jasperbom/nerdhome-breeze/daikin/docs/render_bottom.png

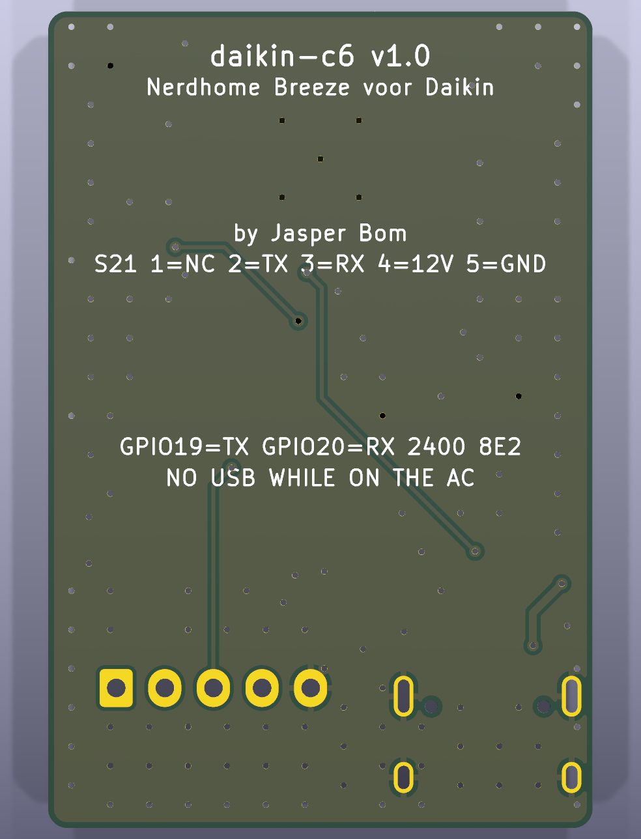
daikin/docs/render_bottom.png
