jasperbom/nerdhome-breeze/daikin/docs/render_top.png

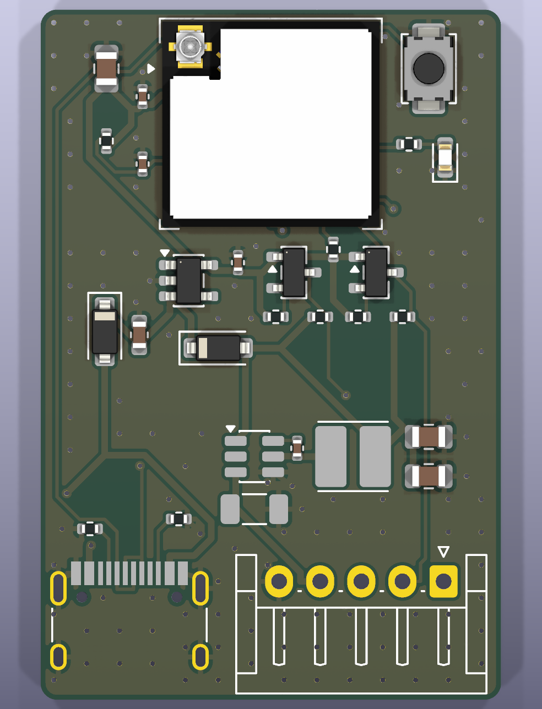
daikin/docs/render_top.png
