jasperbom/nerdhome-breeze/toshiba/docs/product_enclosure.png

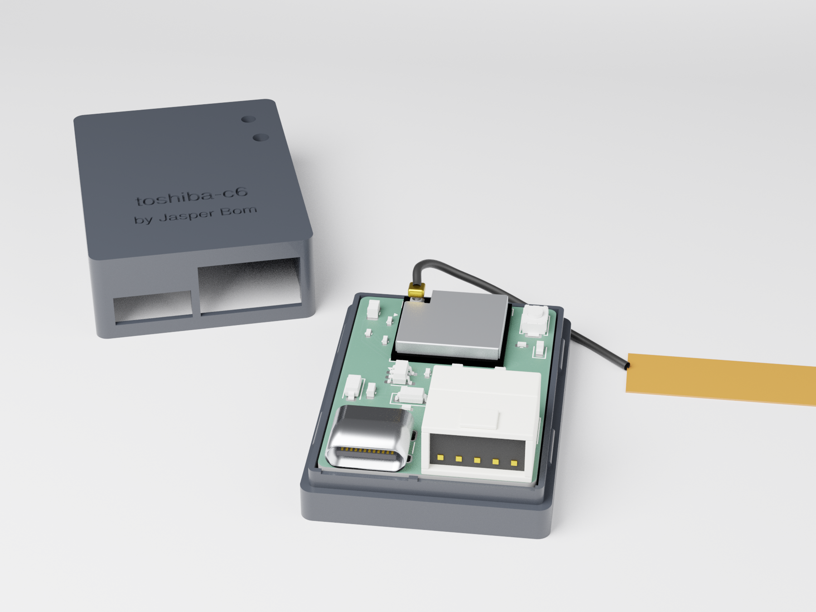
toshiba/docs/product_enclosure.png
