jasperbom/nerdhome-breeze/toshiba/docs/render_bottom.png

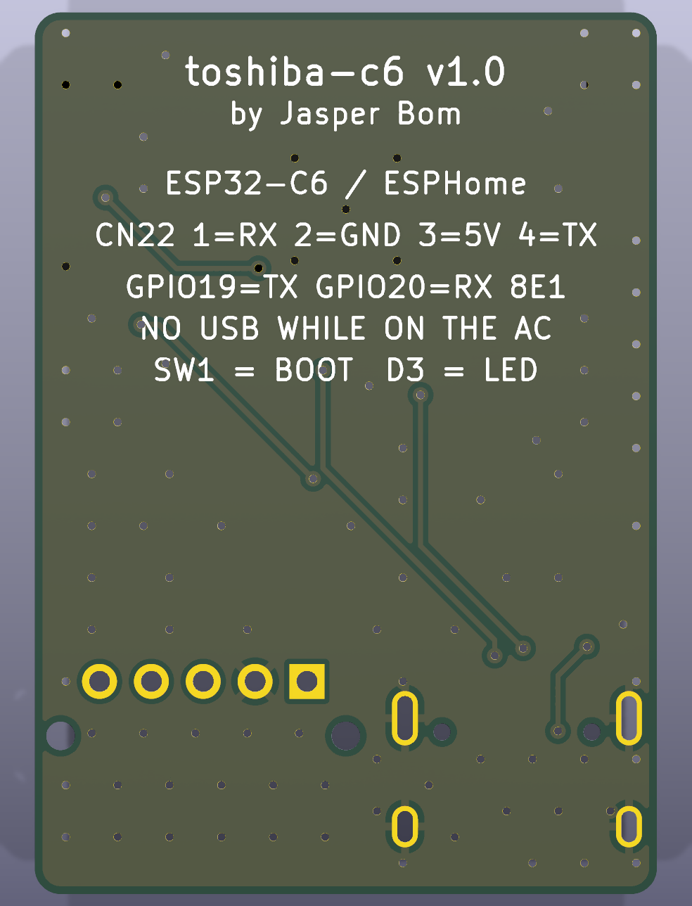
toshiba/docs/render_bottom.png
