jasperbom/nerdhome-breeze/toshiba/docs/render_top.png

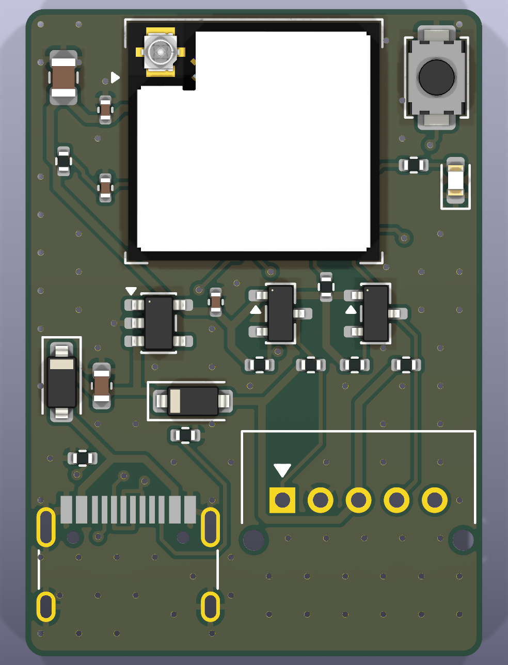
toshiba/docs/render_top.png
