jasperbom/nerdhome-breeze/daikin/production/daikin-c6_bom_jlcpcb.csv

Comment | Designator | Footprint | LCSC Part # | Quantity | MPN
10uF | C1 | C_0603_1608Metric | C19702 | 1 | CL10A106KP8NNNC
22uF | C2,C7,C8 | C_0805_2012Metric | C45783 | 3 | CL21A226MAQNNNE
100nF | C3,C9 | C_0402_1005Metric | C1525 | 2 | CL05B104KO5NNNC
1uF | C4,C5 | C_0402_1005Metric | C52923 | 2 | CL05A105KA5NQNC
10uF 50V | C6 | C_1206_3216Metric | C13585 | 1 | CL31A106KBHNNNE
B5819W | D1,D2 | D_SOD-123 | C8598 | 2 | B5819W SL
Red | D3 | LED_0603_1608Metric | C2286 | 1 | KT-0603R
Daikin S21 (JST EH) | J1 | JST_EH_S5B-EH_1x05_P2.50mm_Horizontal | C265103 | 1 | S5B-EH(LF)(SN)
USB-C | J2 | USB_C_Receptacle_HRO_TYPE-C-31-M-12 | C165948 | 1 | TYPE-C-31-M-12
4.7uH | L1 | L_Cenker_CKCS4030 | C354587 | 1 | CKCS4030-4.7uH/M
AO3400A | Q1,Q2 | SOT-23 | C20917 | 2 | AO3400A
10k | R1,R2,R3,R4,R5,R6 | R_0402_1005Metric | C25744 | 6 | 0402WGF1002TCE
1k | R7 | R_0402_1005Metric | C11702 | 1 | 0402WGF1001TCE
5.1k | R8,R9 | R_0402_1005Metric | C25905 | 2 | 0402WGF5101TCE
BOOT | SW1 | SW_SPST_TS-1088-xR020 | C455280 | 1 | TS-1088R-02026
ESP32-C6-MINI-1U-H4 | U1 | ESP32-C6-MINI-1U | C20627095 | 1 | ESP32-C6-MINI-1U-H4
AP2112K-3.3 | U2 | SOT-23-5 | C51118 | 1 | AP2112K-3.3TRG1
AP63205WU-7 | U3 | TSOT-23-6 | C2071056 | 1 | AP63205WU-7
