jasperbom/nerdhome-breeze/daikin/hardware/3dmodels/ESP32-C6-MINI-1U.step

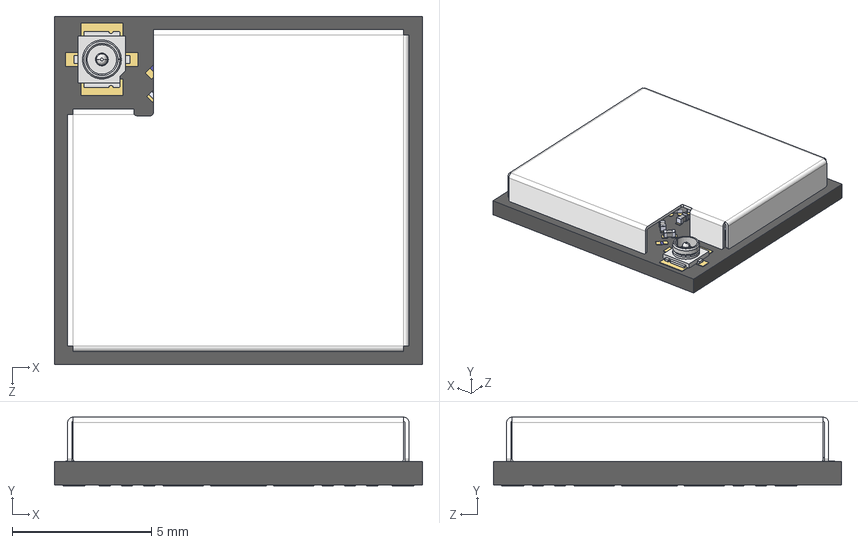
[picture p8: CAD file, 2026-10-19]
daikin/hardware/3dmodels/ESP32-C6-MINI-1U.step
13.2 x 2.47 x 12.5 mm
uid__2428
ipx3.xtd
R0201_20210301.xtd x 3
L0201_20210301.xtd x 2
C0201_20210301.xtd x 10
C0402_20210301.xtd
DFN1006.xtd
XTAL3225_20210301.xtd
ESP32-C6_QFN32_5X5_202306.xtd
placementOutline
Imported
C3-MINI-solder_pad
ShieldBox_ESP32-C3-MINI-1U_V1.0_20201210
