jasperbom/nerdhome-breeze/toshiba/enclosure/toshiba-c6_mount_lid.step

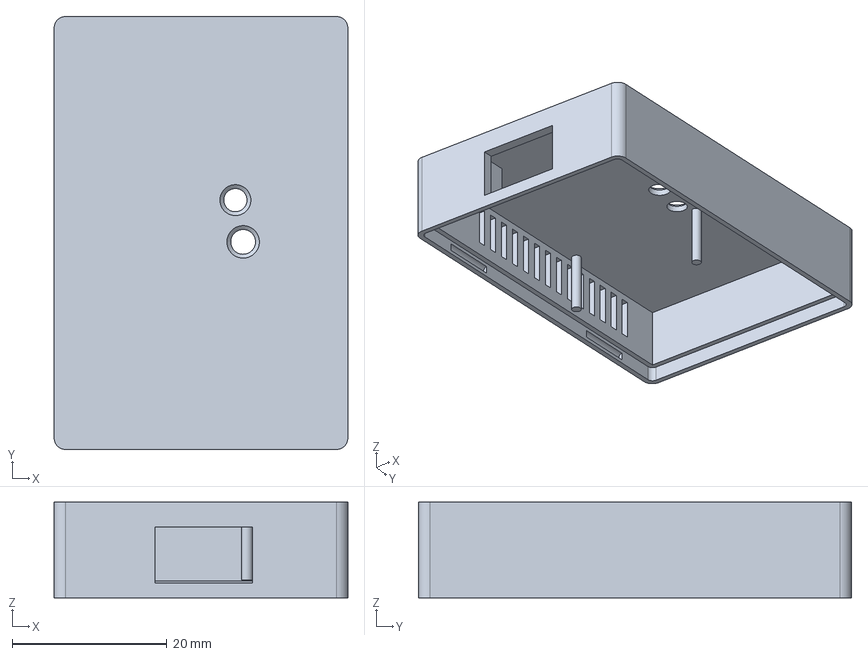
[picture p9: CAD file, 2026-10-19]
toshiba/enclosure/toshiba-c6_mount_lid.step
38.0 x 56.0 x 12.4 mm
