jasperbom/nerdhome-breeze/toshiba/enclosure/toshiba-c6_mount_base.step

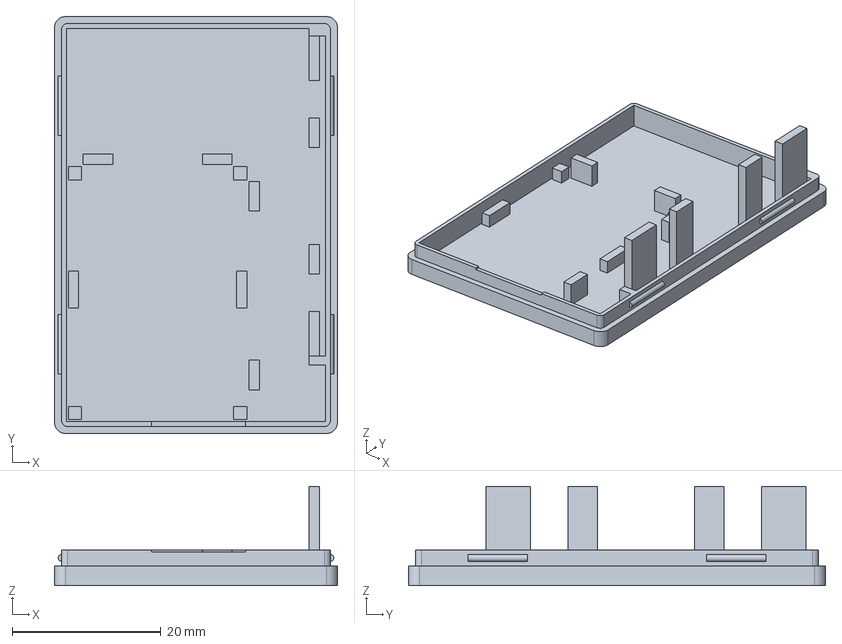
[picture p10: CAD file, 2026-10-19]
toshiba/enclosure/toshiba-c6_mount_base.step
38.0 x 56.0 x 13.3 mm
