jasperbom/nerdhome-breeze/toshiba/enclosure/toshiba-c6_lid.step

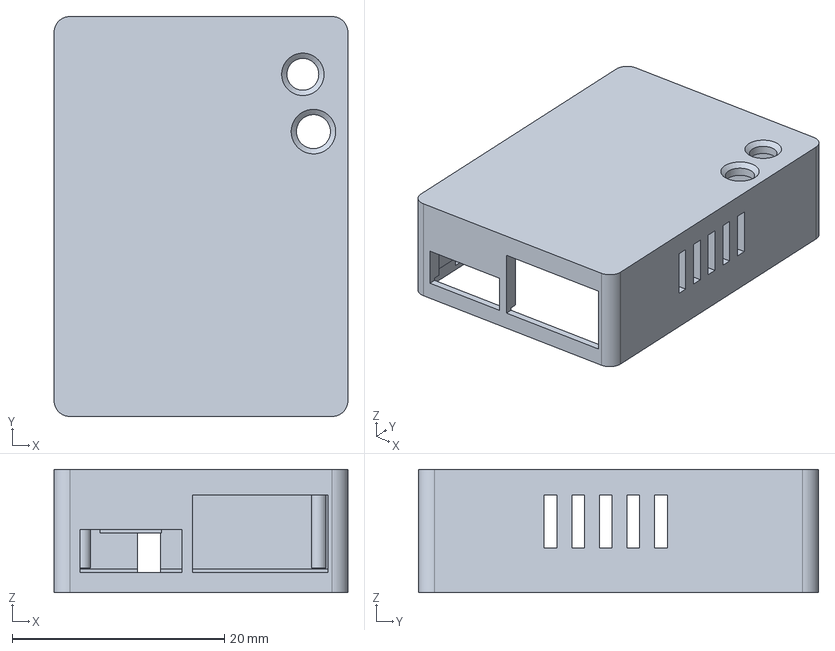
[picture p11: CAD file, 2026-10-19]
toshiba/enclosure/toshiba-c6_lid.step
27.7 x 37.7 x 11.6 mm
