jasperbom/nerdhome-breeze/toshiba/enclosure/toshiba-c6_base.step

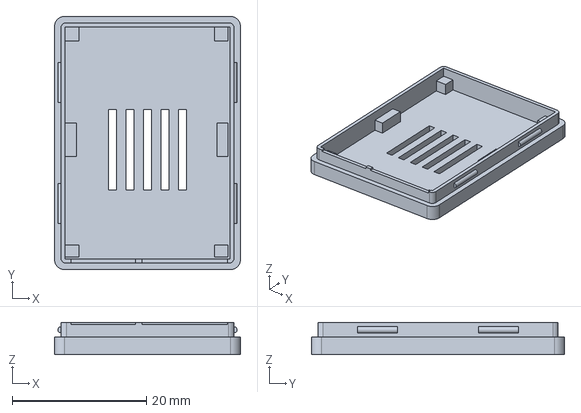
[picture p12: CAD file, 2026-10-19]
toshiba/enclosure/toshiba-c6_base.step
27.7 x 37.7 x 4.80 mm
