jasperbom/nerdhome-breeze/(list of files, cad)

Other CAD files:
toshiba/enclosure/toshiba-c6_base.stl
toshiba/enclosure/toshiba-c6_lid.stl
toshiba/enclosure/toshiba-c6_mount_base.stl
toshiba/enclosure/toshiba-c6_mount_lid.stl
