jasperbom/nerdhome-breeze/toshiba/docs/assembly_top.png

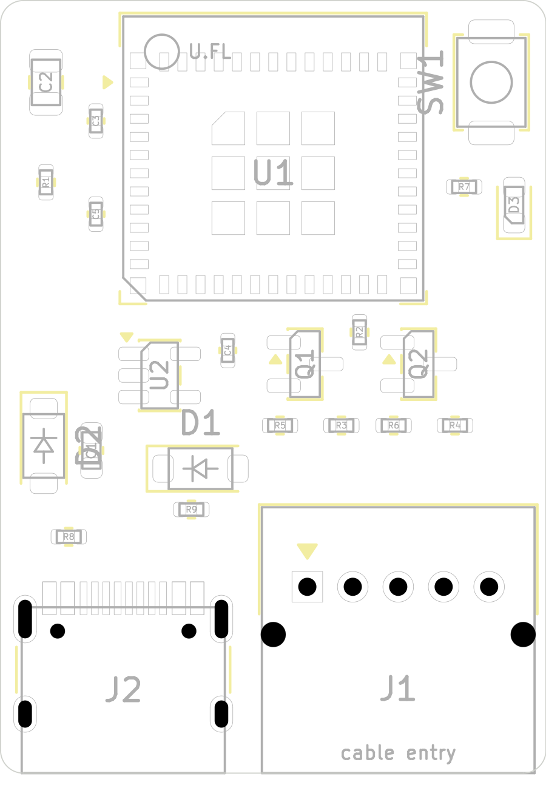
toshiba/docs/assembly_top.png
