jasperbom/nerdhome-breeze/daikin/docs/daikin-c6_assembly.pdf

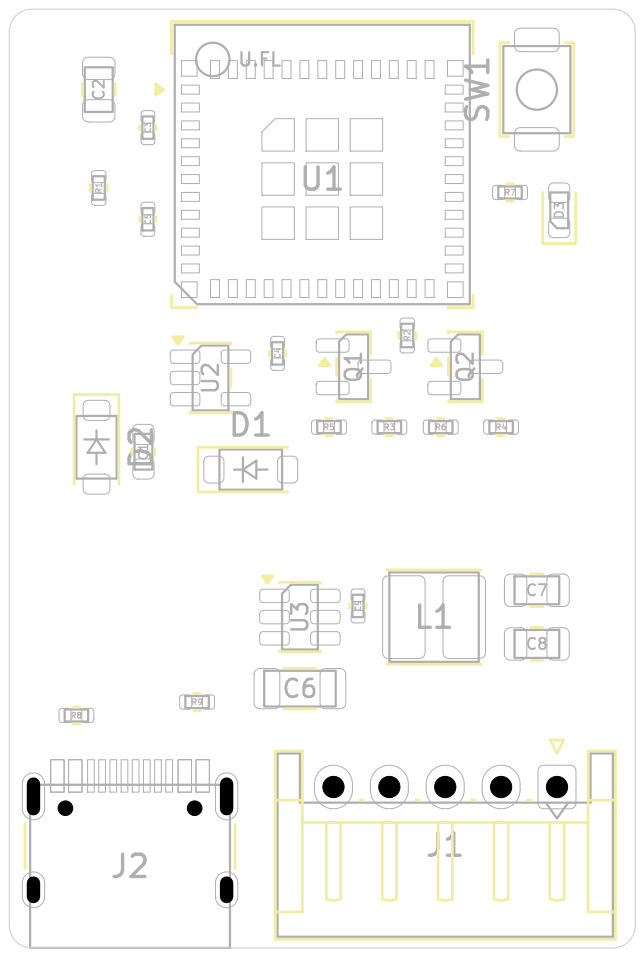
[picture p14: page 1]

Id: 1/1 Title: File: daikin-c6.kicad_pcb Sheet:
