jasperbom/nerdhome-breeze/daikin/docs/daikin-c6_schematic.pdf

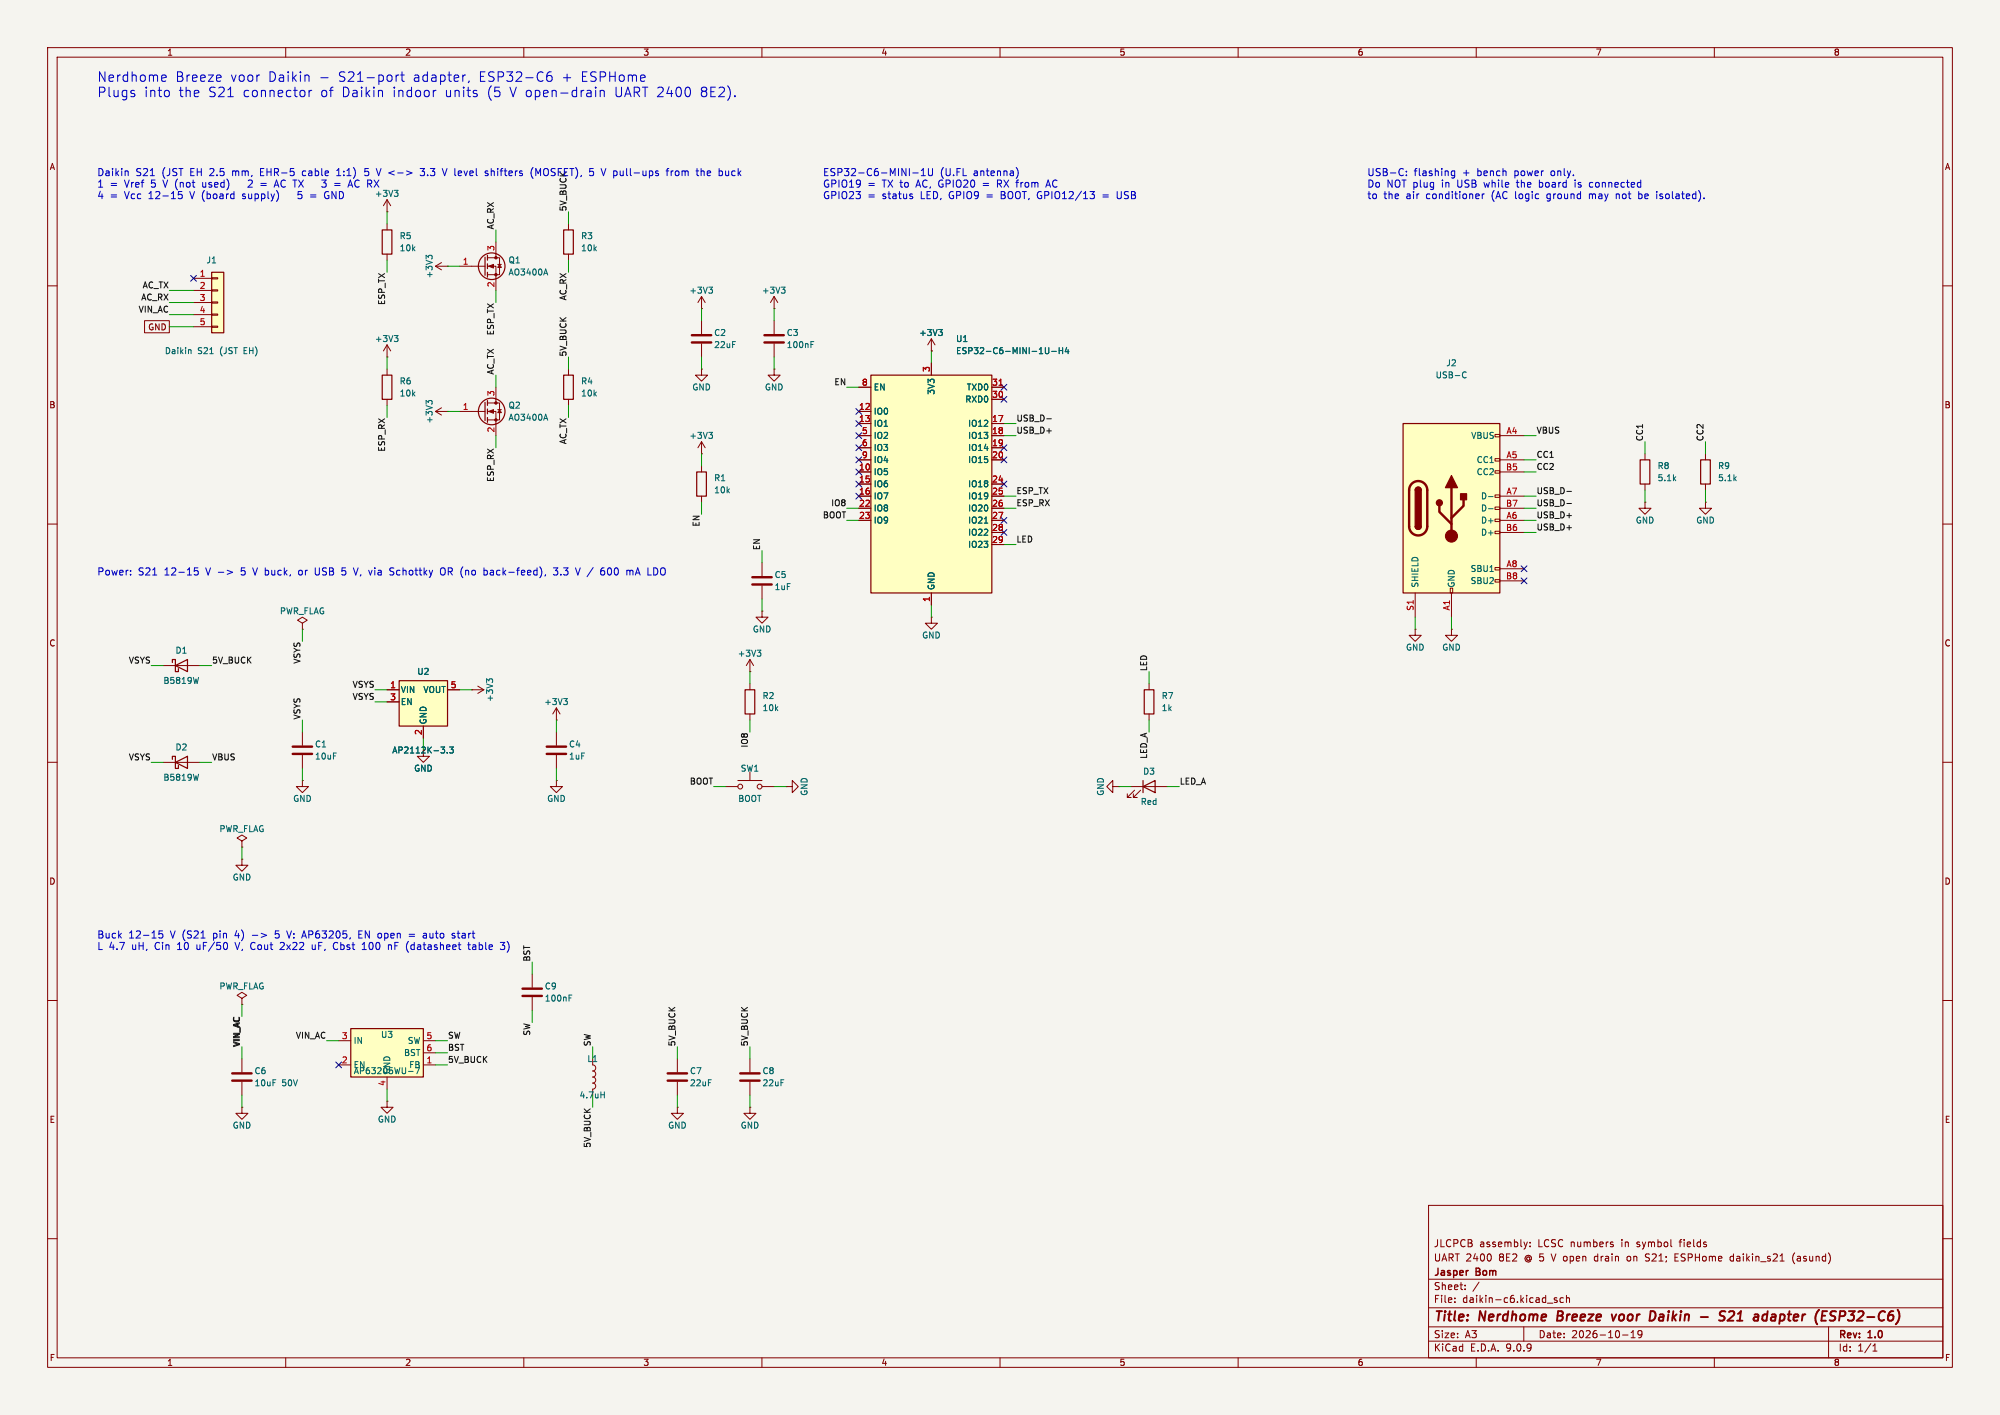
[picture p15: page 1]

4 SW 5 BST 6 FB 1 U3 AP63205WU-7 GND
