jasperbom/nerdhome-breeze/toshiba/docs/toshiba-c6_assembly.pdf

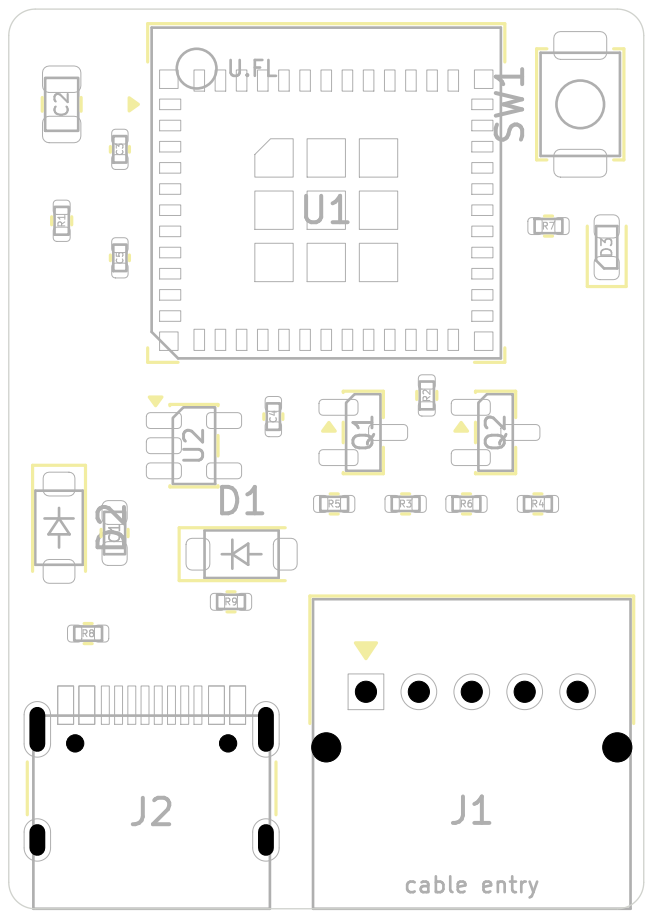
[picture p16: page 1]
