jasperbom/nerdhome-breeze/toshiba/docs/toshiba-c6_schematic.pdf

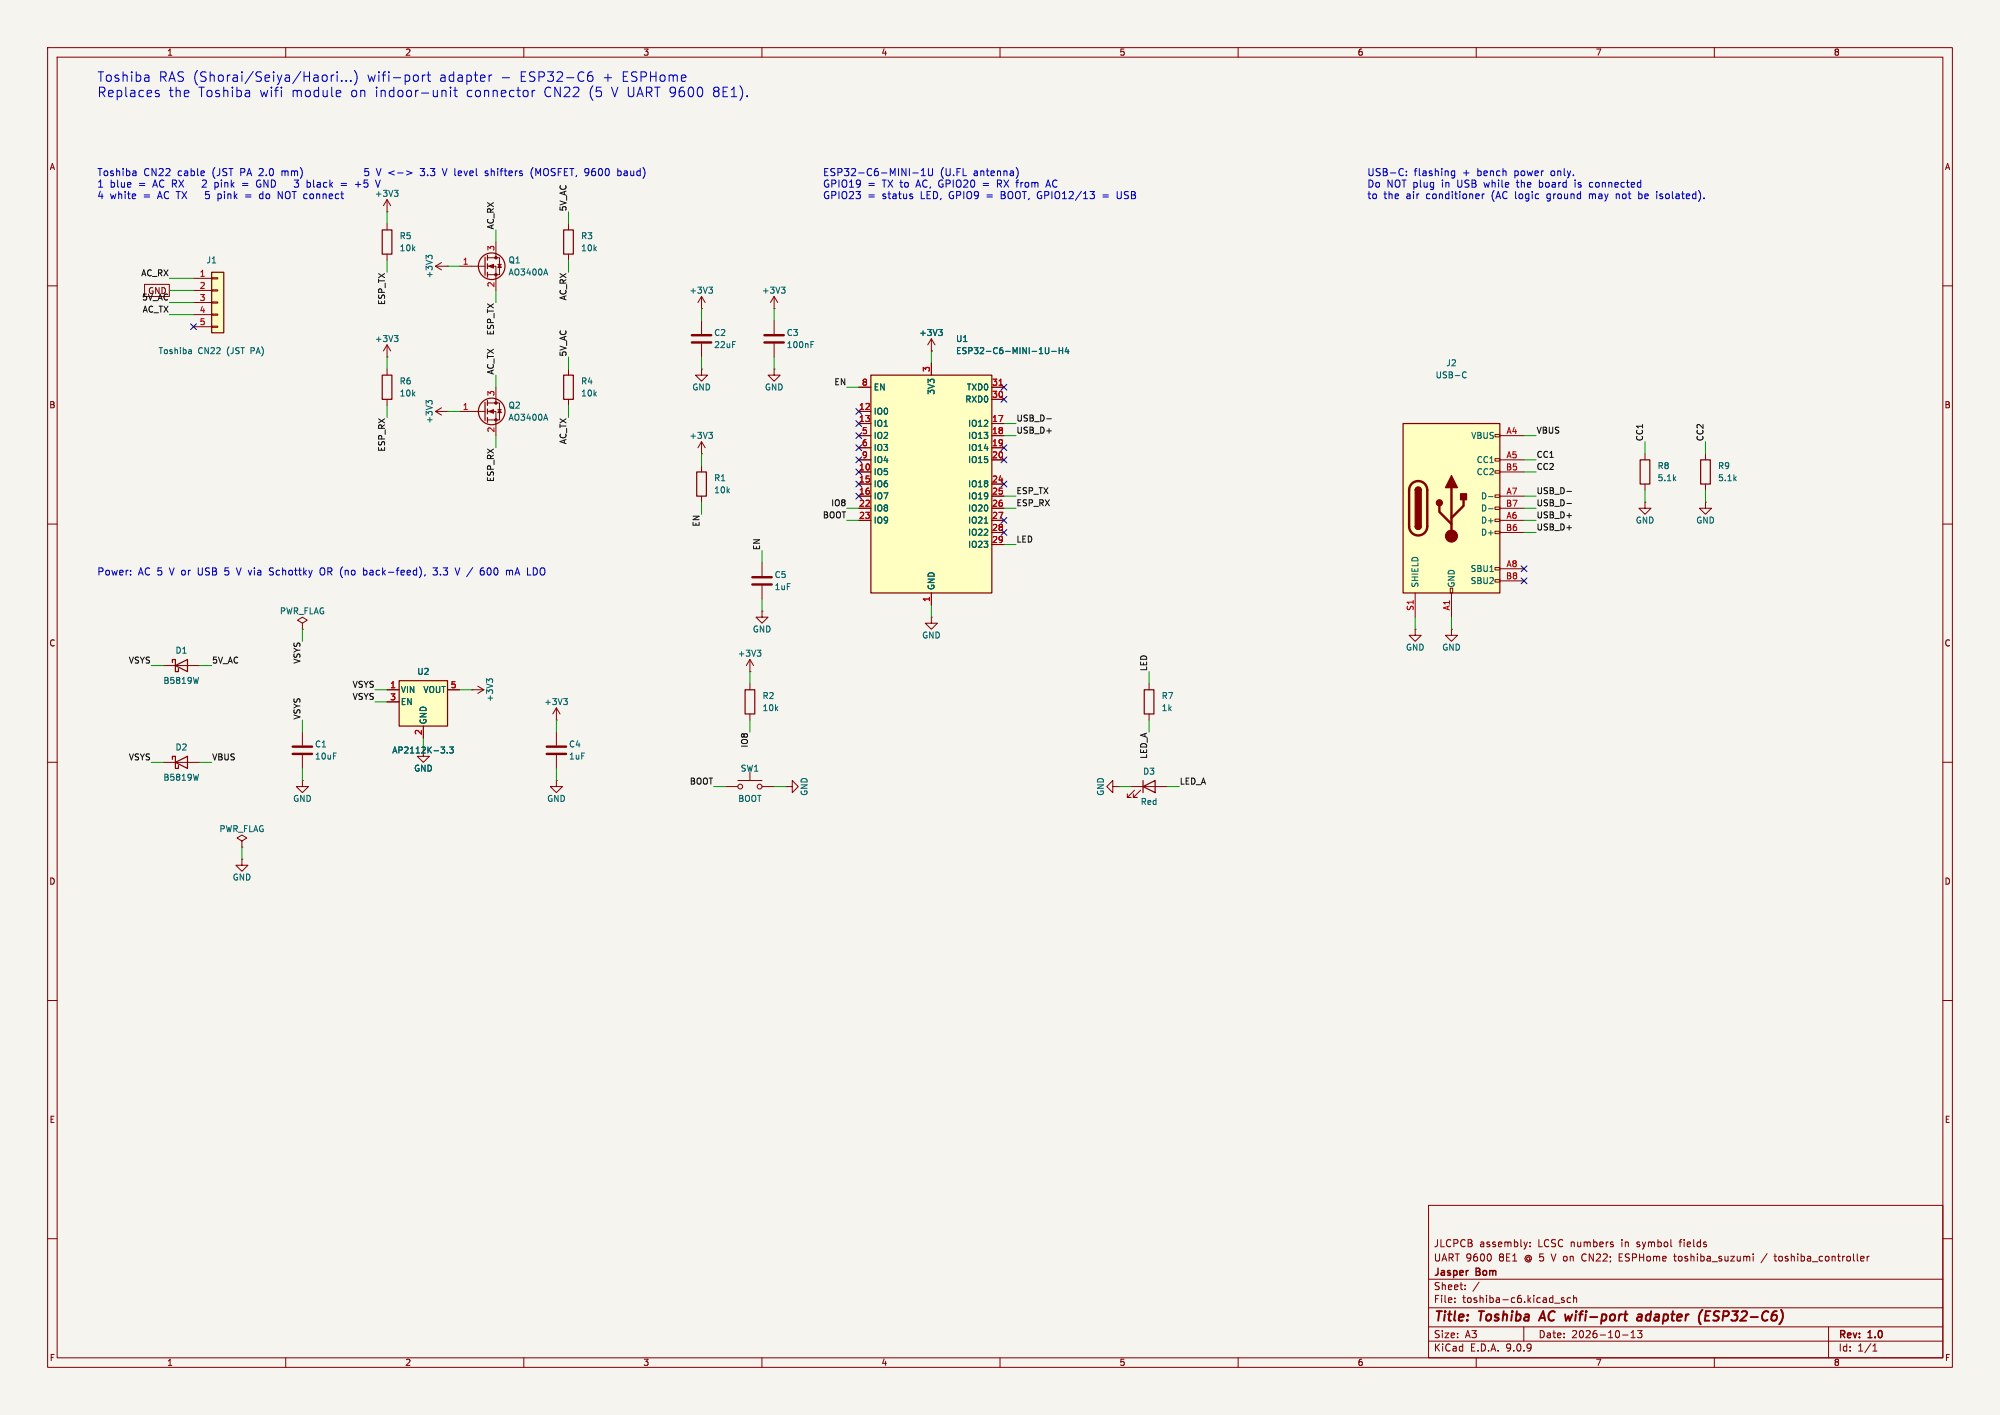
[picture p17: page 1]
