jasperbom/nerdhome-breeze/toshiba/hardware/toshiba-c6.kicad_pcb

## KiCad design toshiba/hardware/toshiba-c6.kicad_pcb (2026-10-19)

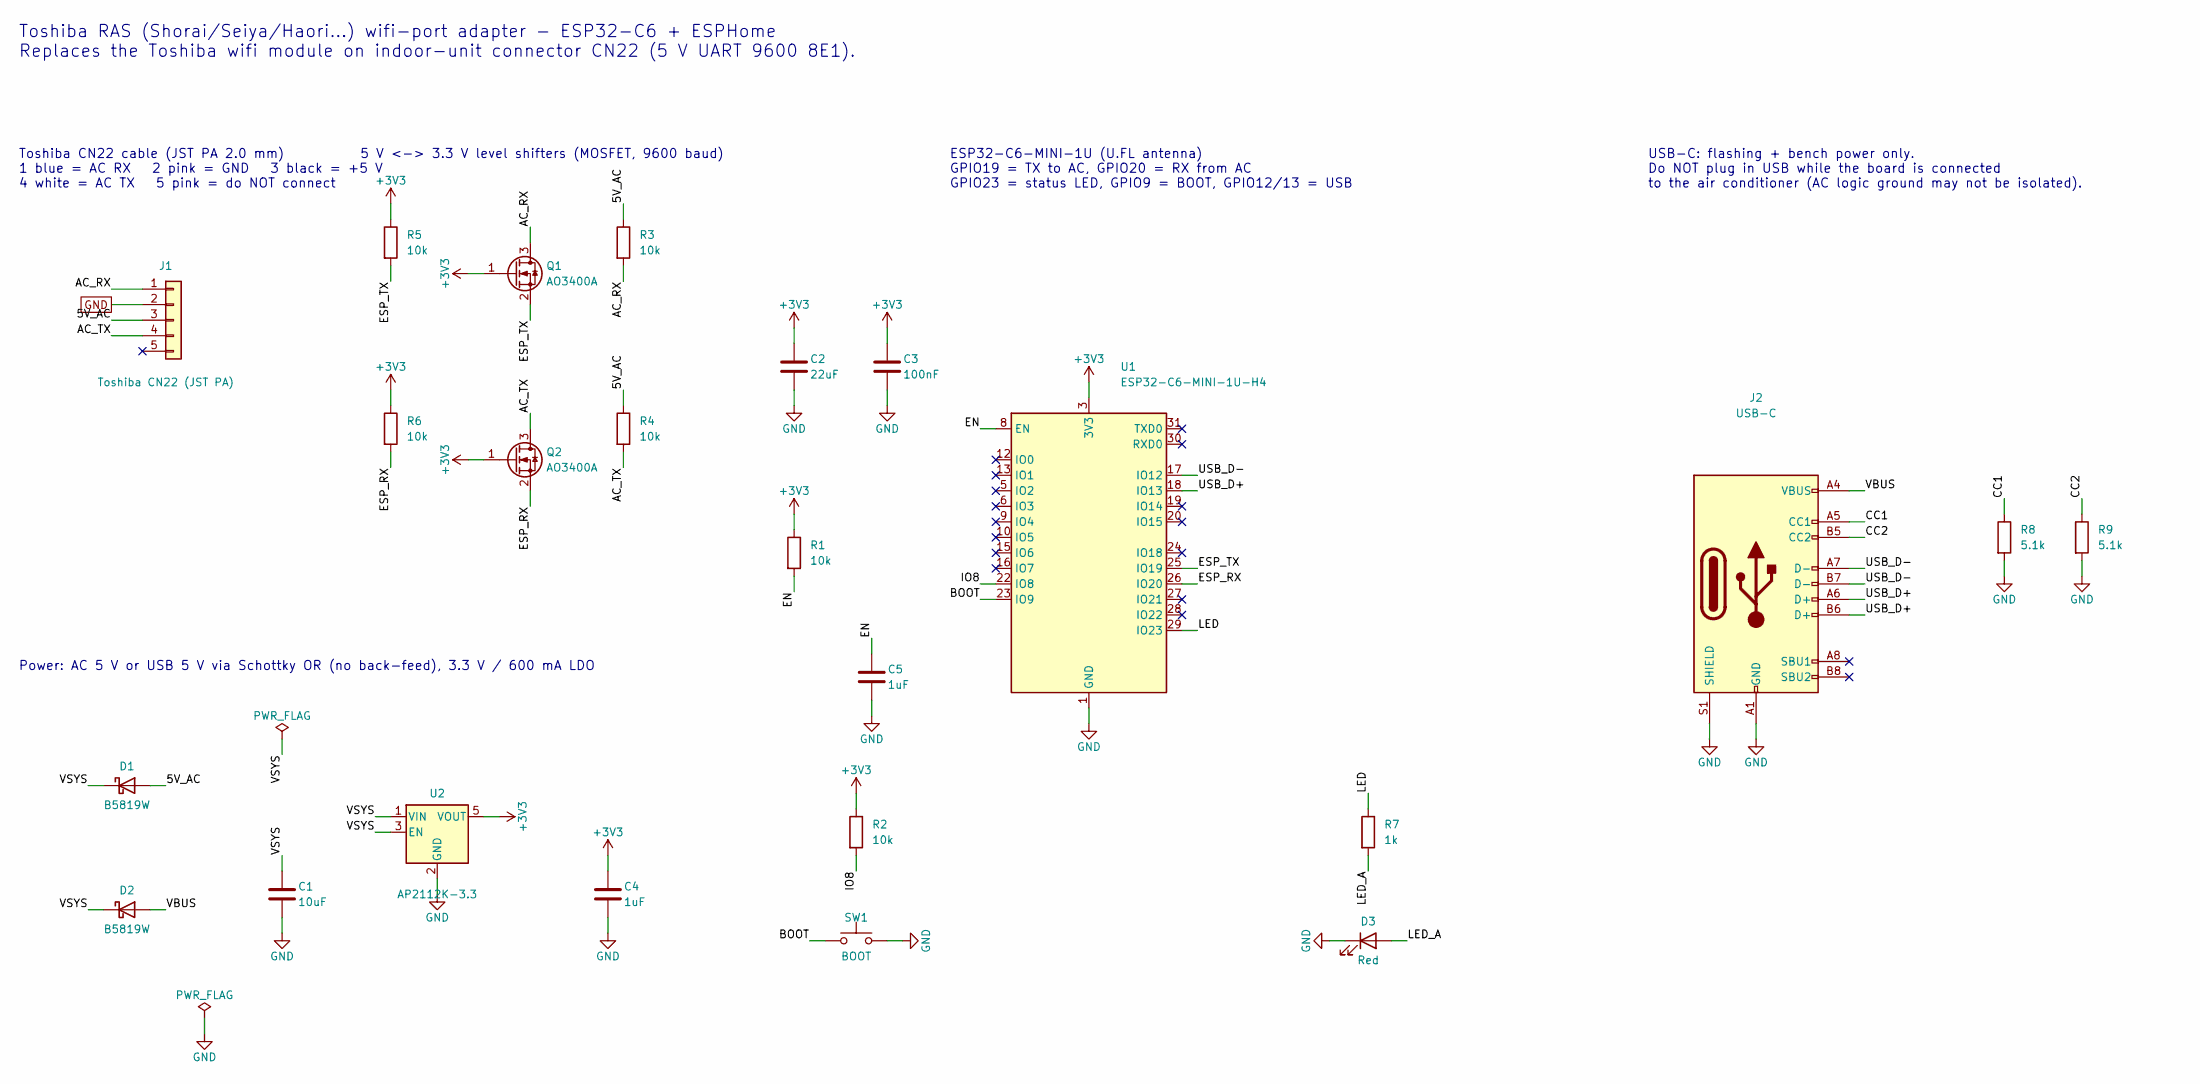
[picture p18: schematic toshiba-c6.kicad_sch, Toshiba AC wifi-port adapter (ESP32-C6)]

Parts:
C1: 10uF; C_0603_1608Metric; MPN CL10A106KP8NNNC; LCSC C19702
C2: 22uF; C_0805_2012Metric; MPN CL21A226MAQNNNE; LCSC C45783
C3: 100nF; C_0402_1005Metric; MPN CL05B104KO5NNNC; LCSC C1525
C4, C5: 1uF; C_0402_1005Metric; MPN CL05A105KA5NQNC; LCSC C52923
D1, D2: B5819W; D_SOD-123; MPN B5819W SL; LCSC C8598
D3: Red; LED_0603_1608Metric; MPN KT-0603R; LCSC C2286
J1: Toshiba CN22 (JST PA); JST_PA_S05B-PASK-2_1x05_P2.00mm_Horizontal; MPN S05B-PASK-2(LF)(SN); LCSC C489718
J2: USB-C; USB_C_Receptacle_HRO_TYPE-C-31-M-12; MPN TYPE-C-31-M-12; LCSC C165948
Q1, Q2: AO3400A; SOT-23; MPN AO3400A; LCSC C20917
R1, R2, R3, R4, R5, R6: 10k; R_0402_1005Metric; MPN 0402WGF1002TCE; LCSC C25744
R7: 1k; R_0402_1005Metric; MPN 0402WGF1001TCE; LCSC C11702
R8, R9: 5.1k; R_0402_1005Metric; MPN 0402WGF5101TCE; LCSC C25905
SW1: BOOT; SW_SPST_TS-1088-xR020; MPN TS-1088R-02026; LCSC C455280
U1: ESP32-C6-MINI-1U-H4; ESP32-C6-MINI-1U; MPN ESP32-C6-MINI-1U-H4; LCSC C20627095
U2: AP2112K-3.3; SOT-23-5; MPN AP2112K-3.3TRG1; LCSC C51118

Connections:
+3V3: C2.1, C3.1, C4.1, Q1.1 (G), Q2.1 (G), R1.1, R2.1, R5.1, R6.1, U1.3 (3V3), U2.5 (VOUT)
/5V_AC: D1.2 (A), J1.3, R3.1, R4.1
/AC_RX: J1.1, Q1.3 (D), R3.2
/AC_TX: J1.4, Q2.3 (D), R4.2
/BOOT: SW1.1, U1.23 (IO9)
/CC1: J2.A5 (CC1), R8.1
/CC2: J2.B5 (CC2), R9.1
/EN: C5.1, R1.2, U1.8 (EN)
/ESP_RX: Q2.2 (S), R6.2, U1.26 (IO20)
/ESP_TX: Q1.2 (S), R5.2, U1.25 (IO19)
/IO8: R2.2, U1.22 (IO8)
/LED: R7.1, U1.29 (IO23)
/LED_A: D3.2 (A), R7.2
/USB_D+: J2.A6 (D+), J2.B6 (D+), U1.18 (IO13)
/USB_D-: J2.A7 (D-), J2.B7 (D-), U1.17 (IO12)
/VBUS: D2.2 (A), J2.A4 (VBUS), J2.A9 (VBUS), J2.B4 (VBUS), J2.B9 (VBUS)
/VSYS: C1.1, D1.1 (K), D2.1 (K), U2.1 (VIN), U2.3 (EN)
GND: C1.2, C2.2, C3.2, C4.2, C5.2, D3.1 (K), J1.2, J2.A1 (GND), J2.A12 (GND), J2.B1 (GND), J2.B12 (GND), J2.S1 (SHIELD), R8.2, R9.2, SW1.2, U1.1 (GND), U1.2 (GND), U1.11 (GND), U1.14 (GND), U1.36 (GND), U1.37 (GND), U1.38 (GND), U1.39 (GND), U1.40 (GND), U1.41 (GND), U1.42 (GND), U1.43 (GND), U1.44 (GND), U1.45 (GND), U1.46 (GND), U1.47 (GND), U1.48 (GND), U1.49 (GND), U1.50 (GND), U1.51 (GND), U1.52 (GND), U1.53 (GND), U2.2 (GND)

Notes on the sheet:
Toshiba RAS (Shorai/Seiya/Haori...) wifi-port adapter - ESP32-C6 + ESPHome Replaces the Toshiba wifi module on indoor-unit connector CN22 (5 V UART 9600 8E1).
Toshiba CN22 cable (JST PA 2.0 mm) 1 blue = AC RX 2 pink = GND 3 black = +5 V 4 white = AC TX 5 pink = do NOT connect
5 V <-> 3.3 V level shifters (MOSFET, 9600 baud)
Power: AC 5 V or USB 5 V via Schottky OR (no back-feed), 3.3 V / 600 mA LDO
ESP32-C6-MINI-1U (U.FL antenna) GPIO19 = TX to AC, GPIO20 = RX from AC GPIO23 = status LED, GPIO9 = BOOT, GPIO12/13 = USB
USB-C: flashing + bench power only. Do NOT plug in USB while the board is connected to the air conditioner (AC logic ground may not be isolated).

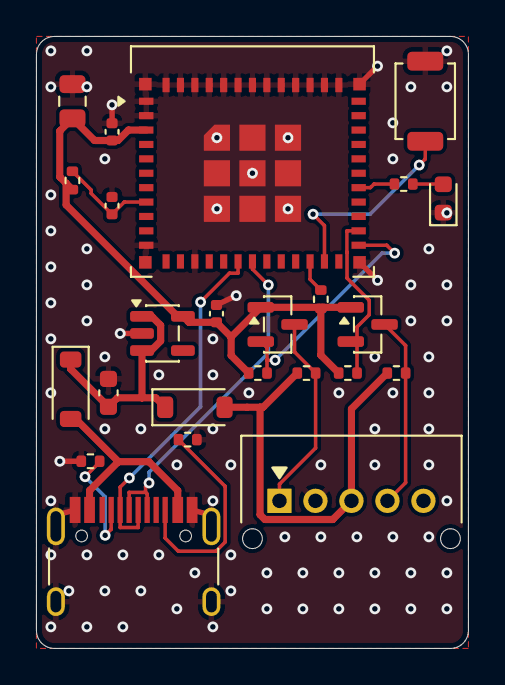
[picture p19: board toshiba-c6.kicad_pcb from above]

Board: 2 copper layers, 24.0 x 34.0 mm, 24 parts (0 on the bottom side), 18 nets.
