jasperbom/nerdhome-breeze/esphome/components/toshiba_suzumi/toshiba_climate.cpp

#include "toshiba_climate.h"
#include "toshiba_climate_mode.h"
#include "esphome/core/log.h"
#include <cmath>
#ifdef USE_TIME
#include "esphome/components/time/real_time_clock.h"
#endif

namespace esphome {
namespace toshiba_suzumi {

using namespace esphome::climate;

static const int RECEIVE_TIMEOUT = 200;
static const int COMMAND_DELAY = 100;
// Nerdhome: how long a compressor reading from an ODU status message stays valid.
// A running unit sends ODU status every few seconds; without a recent one the
// climate action falls back to the selected mode.
static const uint32_t ODU_STATUS_TIMEOUT_MS = 180000;

/**
 * Checksum is calculated from all bytes excluding start byte.
 * It's (256 - (sum % 256)).
 */
uint8_t checksum(std::vector<uint8_t> data, uint8_t length) {
  uint8_t sum = 0;
  for (size_t i = 1; i < length; i++) {
    sum += data[i];
  }
  return 256 - sum;
}

ToshibaClimateUart::ToshibaClimateUart() {
  this->last_time_sync_ = 0;
  this->last_energy_sync_ = 0;
  this->last_total_daily_energy_ = 0;
  this->last_energy_update_ms_ = 0;
  for (int i = 0; i < 24; i++) {
    this->daily_energy_usage_[i] = 0;
  }
}

/**
 * Send the command to UART interface.
 */
void ToshibaClimateUart::send_to_uart(ToshibaCommand command) {
  this->last_command_timestamp_ = millis();
  ESP_LOGV(TAG, "Sending: [%s]", format_hex_pretty(command.payload).c_str());
  this->write_array(command.payload);
}

/**
 * Send starting handshake to initialize communication with the unit.
 */
void ToshibaClimateUart::start_handshake() {
  ESP_LOGCONFIG(TAG, "Sending handshake...");
  enqueue_command_(ToshibaCommand{.cmd = ToshibaCommandType::HANDSHAKE, .payload = HANDSHAKE[0]});
  enqueue_command_(ToshibaCommand{.cmd = ToshibaCommandType::HANDSHAKE, .payload = HANDSHAKE[1]});
  enqueue_command_(ToshibaCommand{.cmd = ToshibaCommandType::HANDSHAKE, .payload = HANDSHAKE[2]});
  enqueue_command_(ToshibaCommand{.cmd = ToshibaCommandType::HANDSHAKE, .payload = HANDSHAKE[3]});
  enqueue_command_(ToshibaCommand{.cmd = ToshibaCommandType::HANDSHAKE, .payload = HANDSHAKE[4]});
  enqueue_command_(ToshibaCommand{.cmd = ToshibaCommandType::HANDSHAKE, .payload = HANDSHAKE[5]});
  enqueue_command_(ToshibaCommand{.cmd = ToshibaCommandType::DELAY, .delay = 2000});
  enqueue_command_(ToshibaCommand{.cmd = ToshibaCommandType::HANDSHAKE, .payload = AFTER_HANDSHAKE[0]});
  enqueue_command_(ToshibaCommand{.cmd = ToshibaCommandType::HANDSHAKE, .payload = AFTER_HANDSHAKE[1]});
}

/**
 * Handle data in RX buffer, validate message for content and checksum.
 * Since we know the format only of some messages (expected length), unknown messages
 * are ended via RECIEVE timeout.
 */
bool ToshibaClimateUart::validate_message_() {
  uint8_t at = this->rx_message_.size() - 1;
  auto *data = &this->rx_message_[0];
  uint8_t new_byte = data[at];

  // Byte 0: HEADER (always 0x02)
  if (at == 0)
    return new_byte == 0x02;

  // always get first three bytes
  if (at < 2) {
    return true;
  }

  // Byte 3
  if (data[2] != 0x03) {
    // Normal commands starts with 0x02 0x00 0x03 and have length between 15-17 bytes.
    // however there are some special unknown handshake commands which has non-standard replies.
    // Since we don't know their format, we can't validate them.
    return true;
  }

  if (at <= 5) {
    // no validation for these fields
    return true;
  }

  // Byte 7: LENGTH
  uint8_t length = 6 + data[6] + 1;  // prefix + data + checksum

  // wait until all data is read
  if (at < length)
    return true;

  // last byte: CHECKSUM
  uint8_t rx_checksum = new_byte;
  uint8_t calc_checksum = checksum(this->rx_message_, at);

  if (rx_checksum != calc_checksum) {
    ESP_LOGW(TAG, "Received invalid message checksum %02X!=%02X DATA=[%s]", rx_checksum, calc_checksum,
             format_hex_pretty(data, length).c_str());
    return false;
  }

  // valid message
  ESP_LOGV(TAG, "Received: DATA=[%s]", format_hex_pretty(data, length).c_str());
  this->parseResponse(this->rx_message_);

  // return false to reset rx buffer
  return false;
}

void ToshibaClimateUart::enqueue_command_(const ToshibaCommand &command) {
  this->command_queue_.push_back(command);
  this->process_command_queue_();
}

void ToshibaClimateUart::sendCmd(ToshibaCommandType cmd, uint8_t value) {
  std::vector<uint8_t> payload = {2, 0, 3, 16, 0, 0, 7, 1, 48, 1, 0, 2};
  payload.push_back(static_cast<uint8_t>(cmd));
  payload.push_back(value);
  payload.push_back(checksum(payload, payload.size()));
  ESP_LOGD(TAG, "Sending ToshibaCommand: %d, value: %d, checksum: %d", cmd, value, payload[14]);
  this->enqueue_command_(ToshibaCommand{.cmd = cmd, .payload = std::vector<uint8_t>{payload}});
}

void ToshibaClimateUart::requestData(ToshibaCommandType cmd) {
  std::vector<uint8_t> payload = {2, 0, 3, 16, 0, 0, 6, 1, 48, 1, 0, 1};
  payload.push_back(static_cast<uint8_t>(cmd));
  payload.push_back(checksum(payload, payload.size()));
  ESP_LOGI(TAG, "Requesting data from sensor %d, checksum: %d", payload[12], payload[13]);
  this->enqueue_command_(ToshibaCommand{.cmd = cmd, .payload = std::vector<uint8_t>{payload}});
}

void ToshibaClimateUart::getInitData() {
  ESP_LOGD(TAG, "Requesting initial data from AC unit");
  this->requestData(ToshibaCommandType::POWER_STATE);
  if (this->self_clean_sensor_ != nullptr) {
    this->requestData(ToshibaCommandType::SELF_CLEAN);
  }
  this->requestData(ToshibaCommandType::MODE);
  this->requestData(ToshibaCommandType::TARGET_TEMP);
  this->requestData(ToshibaCommandType::FAN);
  this->requestData(ToshibaCommandType::POWER_SEL);
  this->requestData(ToshibaCommandType::SWING);
  this->requestData(ToshibaCommandType::ROOM_TEMP);
  this->requestData(ToshibaCommandType::OUTDOOR_TEMP);
  this->requestData(ToshibaCommandType::SPECIAL_MODE);
  if (this->plasma_switch_ != nullptr) {
    this->requestData(ToshibaCommandType::PLASMA);
  }
  if (this->energy_sensor_ != nullptr || this->power_sensor_ != nullptr) {
    this->requestData(ToshibaCommandType::ENERGY_DAILY);
  }
}

void ToshibaClimateUart::set_self_clean_running_(bool running) {
  this->self_clean_running_ = running;
  if (this->self_clean_sensor_ != nullptr) {
    this->self_clean_sensor_->publish_state(running);
  }
}

/**
 * Configure the supported custom modes and presets for the climate component.
 * This is needed because the Toshiba AC has more FAN levels and presets than the standard climate component supports.
 * see https://developers.esphome.io/blog/2026/04/09/climate-and-fan-custom-mode-vectors-moved-to-entity/
 */
void ToshibaClimateUart::configure_supported_custom_modes_() {
  // Toshiba AC has more FAN levels than the standard climate component supports.
  this->set_supported_custom_fan_modes({CUSTOM_FAN_LEVEL_2, CUSTOM_FAN_LEVEL_4});

  // go over all defined presets and filter out the ones that are supported by the climate component
  if (!this->supported_presets_.empty()) {
    std::vector<const char *> custom_preset_names;
    for (const char *preset_string : this->supported_presets_) {
      if (!StringToClimatePreset(preset_string).has_value()) {
        // preset is not supported by the climate component, add it to the custom presets
        custom_preset_names.push_back(preset_string);
      }
    }
    // if there are any custom presets, set them for the climate component
    if (!custom_preset_names.empty()) {
      this->set_supported_custom_presets(custom_preset_names);
    }
  }
}

void ToshibaClimateUart::setup() {
  this->configure_supported_custom_modes_();
  // establish communication
  this->start_handshake();
  // load initial sensor data from the unit
  this->getInitData();
  // Set Wi-Fi LED initial state. Nerdhome: with the wifi_led switch configured, use
  // its restored state (flash) instead of the fixed disable_wifi_led option.
  bool wifi_led_on = !this->wifi_led_disabled_;
  if (this->wifi_led_switch_ != nullptr) {
    wifi_led_on = this->wifi_led_switch_->get_initial_state_with_restore_mode().value_or(wifi_led_on);
    this->wifi_led_switch_->publish_state(wifi_led_on);
  }
  this->set_wifi_led(wifi_led_on);
}

/**
 * Detect RX timeout and send next command in the queue to the unit.
 */
void ToshibaClimateUart::process_command_queue_() {
  uint32_t now = millis();

  uint32_t cmdDelay = now - this->last_command_timestamp_;

  // when we have not processed message and timeout since last received byte has expired,
  // we likely won't receive any more data and there is nothing we can do with the message as it's
  // format is was not recognized by validate_message_ function.
  // Nothing to do - drop the message to free up communication and allow to send next command.
  if (now - this->last_rx_char_timestamp_ > RECEIVE_TIMEOUT) {
    this->rx_message_.clear();
  }

  // when there is no RX message and there is a command to send
  if (cmdDelay > COMMAND_DELAY && !this->command_queue_.empty() && this->rx_message_.empty()) {
    auto newCommand = this->command_queue_.front();
    if (newCommand.cmd == ToshibaCommandType::DELAY && cmdDelay < newCommand.delay) {
      // delay command did not finished yet
      return;
    }
    // DELAY commands don't send data over UART, just remove them from queue
    if (newCommand.cmd == ToshibaCommandType::DELAY) {
      this->command_queue_.erase(this->command_queue_.begin());
      return;
    }
    this->send_to_uart(this->command_queue_.front());
    this->command_queue_.erase(this->command_queue_.begin());
  }
}

/**
 * Handle received byte from UART
 */
void ToshibaClimateUart::handle_rx_byte_(uint8_t c) {
  this->rx_message_.push_back(c);
  if (!validate_message_()) {
    this->rx_message_.clear();
  } else {
    this->last_rx_char_timestamp_ = millis();
  }
}

void ToshibaClimateUart::loop() {
  while (available()) {
    uint8_t c;
    this->read_byte(&c);
    this->handle_rx_byte_(c);
  }
  this->process_command_queue_();
}

void ToshibaClimateUart::parseResponse(std::vector<uint8_t> rawData) {
  uint8_t length = rawData.size();
  ToshibaCommandType sensor;
  uint8_t value;

  switch (length) {
    case 15:  // response to requestData with the actual value of sensor/setting
      sensor = static_cast<ToshibaCommandType>(rawData[12]);
      value = rawData[13];
      break;
    case 16:  // probably ACK for issued command
      // Check if this is a SET_DATE_TIME ACK (ends in 0x99 0x99)
      if (rawData[14] == 0x99) {
          ESP_LOGD(TAG, "AC unit acknowledged time synchronization.");
          this->time_synced_ = true;
      }
      ESP_LOGD(TAG, "Received message with length: %d and value %s", length, format_hex_pretty(rawData).c_str());
      return;
    case 17:  // response to requestData with the actual value of sensor/setting
      sensor = static_cast<ToshibaCommandType>(rawData[14]);
      value = rawData[15];
      break;
    case 69:
    case 70:  // energy daily response
      sensor = static_cast<ToshibaCommandType>(rawData[14]);
      value = 0;
      break;
    case 22:  // extended status message (e.g., ODU_STATUS / IDU_STATUS)
      sensor = static_cast<ToshibaCommandType>(rawData[12]);
      value = 0;
      break;
    case 24:  // extended status message (e.g., ODU_STATUS / IDU_STATUS)
      sensor = static_cast<ToshibaCommandType>(rawData[14]);
      value = 0;
      break;
    case 114:  // Nerdhome: unit identification, sent by the unit every ~4-5 minutes
      if (rawData[12] == 0xE0) {
        this->parse_unit_info_(rawData);
      } else {
        ESP_LOGD(TAG, "Received 114-byte message of unknown type 0x%02X", rawData[12]);
      }
      return;
    default:
      ESP_LOGW(TAG, "Received unknown message with length: %d and value %s", length,
               format_hex_pretty(rawData).c_str());
      return;
  }
  switch (sensor) {
    case ToshibaCommandType::ENERGY_DAILY: {
      // Nerdhome: units without energy monitoring answer with a short message;
      // the hourly table below needs the full 69/70-byte frame.
      if (length < 69) {
        ESP_LOGD(TAG, "Energy register not supported by this unit (length %d)", length);
        break;
      }
      ESP_LOGI(TAG, "Received daily energy update");
      uint32_t total_energy = 0;
#ifdef USE_TIME
      uint8_t current_hour = (this->time_ != nullptr) ? this->time_->now().hour : 25;
#else
      uint8_t current_hour = 25;
#endif
      for (uint8_t i = 0; i < 24; i++) {
        uint16_t hour_val = (rawData[21 + (i * 2) + 1] << 8) | rawData[21 + (i * 2)];
        this->daily_energy_usage_[i] = hour_val;
        total_energy += hour_val;
        if (i == current_hour) {
            ESP_LOGD(TAG, "  Current hour (%d) consumption: %u Wh", i, hour_val);
        }
      }
      if (this->energy_sensor_ != nullptr) {
        this->energy_sensor_->publish_state(total_energy);
      }
      this->estimate_wattage_(total_energy);
      break;
    }
    case ToshibaCommandType::TARGET_TEMP:
      ESP_LOGI(TAG, "Received target temp: %d", value);
      if (this->special_mode_ == SPECIAL_MODE::EIGHT_DEG) {
        // if special mode is EIGHT_DEG, shift the target temperature by SPECIAL_TEMP_OFFSET
        value -= SPECIAL_TEMP_OFFSET;

        ESP_LOGI(TAG, "Note: Special Mode \"%s\" is active, shifting target temp to %d", SPECIAL_MODE_EIGHT_DEG, value);
      }
      this->target_temperature = value;
      break;
    case ToshibaCommandType::FAN: {
      if (static_cast<FAN>(value) == FAN::FAN_AUTO) {
        ESP_LOGI(TAG, "Received fan mode: AUTO");
        this->set_fan_mode_(CLIMATE_FAN_AUTO);
      } else if (static_cast<FAN>(value) == FAN::FAN_QUIET) {
        ESP_LOGI(TAG, "Received fan mode: QUIET");
        this->set_fan_mode_(CLIMATE_FAN_QUIET);
      } else if (static_cast<FAN>(value) == FAN::FAN_LOW) {
        ESP_LOGI(TAG, "Received fan mode: LOW");
        this->set_fan_mode_(CLIMATE_FAN_LOW);
      } else if (static_cast<FAN>(value) == FAN::FAN_MEDIUM) {
        ESP_LOGI(TAG, "Received fan mode: MEDIUM");
        this->set_fan_mode_(CLIMATE_FAN_MEDIUM);
      } else if (static_cast<FAN>(value) == FAN::FAN_HIGH) {
        ESP_LOGI(TAG, "Received fan mode: HIGH");
        this->set_fan_mode_(CLIMATE_FAN_HIGH);
      } else {
        auto fanMode = IntToCustomFanMode(static_cast<FAN>(value));
        ESP_LOGI(TAG, "Received fan mode: %s", fanMode);
        this->set_custom_fan_mode_(fanMode);
      }
      break;
    }
    case ToshibaCommandType::SWING: {
      auto swing = static_cast<SWING>(value);
      auto air_direction = SwingToVerticalAirDirection(swing);
      if (air_direction != nullptr) {
        ESP_LOGI(TAG, "Received vertical air direction: %s", air_direction);
        this->publish_vertical_air_direction_(swing);
      }

      if (IsFixedVerticalAirDirection(swing)) {
        this->swing_mode = climate::CLIMATE_SWING_OFF;
      } else {
        auto swingMode = IntToClimateSwingMode(swing);
        ESP_LOGI(TAG, "Received swing mode: %s", climate_swing_mode_to_string(swingMode));
        this->swing_mode = swingMode;
      }
      break;
    }
    case ToshibaCommandType::MODE: {
      auto mode = IntToClimateMode(static_cast<MODE>(value));
      ESP_LOGI(TAG, "Received AC mode: %s", climate_mode_to_string(mode));
      if (this->power_state_ == STATE::ON && !this->self_clean_running_) {
        this->mode = mode;
      }
      break;
    }
    case ToshibaCommandType::ROOM_TEMP:
      if (value != 127) {
        ESP_LOGI(TAG, "Received room temp: %d °C", value);
        this->current_temperature = value;
        if (indoor_temp_sensor_ != nullptr) {
          indoor_temp_sensor_->publish_state((int8_t) value);
        }
      }
      break;
    case ToshibaCommandType::OUTDOOR_TEMP:
      if (value != 127) {
        if (outdoor_temp_sensor_ != nullptr) {
          ESP_LOGI(TAG, "Received outdoor temp: %d °C", (int8_t) value);
          outdoor_temp_sensor_->publish_state((int8_t) value);
        }
      }
      break;
    case ToshibaCommandType::POWER_SEL: {
      auto pwr_level = IntToPowerLevel(static_cast<PWR_LEVEL>(value));
      ESP_LOGI(TAG, "Received power select: %d", value);
      if (pwr_select_ != nullptr) {
        pwr_select_->publish_state(pwr_level);
      }
      break;
    }
    case ToshibaCommandType::POWER_STATE: {
      auto climateState = static_cast<STATE>(value);
      ESP_LOGI(TAG, "Received AC unit power state: %s", climate_state_to_string(climateState));
      if (climateState == STATE::OFF) {
        // AC unit was just powered off, set mode to OFF
        this->mode = climate::CLIMATE_MODE_OFF;
        this->set_self_clean_running_(false);
      } else if (this->self_clean_running_) {
        if (this->self_clean_sensor_ != nullptr) {
          ESP_LOGD(TAG, "Refreshing self-clean status after receiving AC ON state");
          this->requestData(ToshibaCommandType::SELF_CLEAN);
        }
      } else if (this->mode == climate::CLIMATE_MODE_OFF && climateState == STATE::ON) {
        // Unit reports ON while we believe it is off, e.g. powered on via IR
        // remote, or the start of a post-shutdown self-clean cycle. When
        // self-clean reporting is configured, query it first: the SELF_CLEAN
        // response is processed before the MODE response below, so a running
        // cycle keeps the entity OFF (the MODE response is ignored while
        // self-clean is running).
        if (this->self_clean_sensor_ != nullptr) {
          this->requestData(ToshibaCommandType::SELF_CLEAN);
        }
        this->requestData(ToshibaCommandType::MODE);
      }
      this->power_state_ = climateState;
      break;
    }
    case ToshibaCommandType::SELF_CLEAN: {
      auto self_clean_state = static_cast<SELF_CLEAN_STATE>(value);
      bool was_running = this->self_clean_running_;
      if (self_clean_state == SELF_CLEAN_STATE::RUNNING) {
        ESP_LOGI(TAG, "Self-clean is running");
        this->set_self_clean_running_(true);
        this->mode = climate::CLIMATE_MODE_OFF;
      } else if (self_clean_state == SELF_CLEAN_STATE::OFF) {
        ESP_LOGI(TAG, "Self-clean is stopped");
        this->set_self_clean_running_(false);
        if (was_running) {
          // The cycle ended: either it finished (unit now off) or it was
          // interrupted by switching the unit back on. The self-clean register
          // doesn't distinguish these, and the unit only reports power state on
          // change/query (not continuously), so the cached value may be stale.
          // Query the power state to resync; the POWER_STATE handler refreshes
          // the mode when the unit turns out to be on.
          this->requestData(ToshibaCommandType::POWER_STATE);
        }
      } else {
        ESP_LOGW(TAG, "Received unknown self-clean state: %d", value);
      }
      break;
    }
    case ToshibaCommandType::PLASMA: {
      // Nerdhome addition. Only known values are published: a unit without a
      // plasma filter never reports one, so the switch stays "unknown".
      auto plasma_state = static_cast<PLASMA_STATE>(value);
      if (plasma_state == PLASMA_STATE::ON || plasma_state == PLASMA_STATE::OFF) {
        bool on = plasma_state == PLASMA_STATE::ON;
        ESP_LOGI(TAG, "Received plasma filter state: %s", on ? "ON" : "OFF");
        if (this->plasma_switch_ != nullptr) {
          this->plasma_switch_->publish_state(on);
        }
      } else {
        ESP_LOGD(TAG, "Received unsupported plasma filter value: %d", value);
      }
      break;
    }
    case ToshibaCommandType::SPECIAL_MODE: {
      this->special_mode_ = static_cast<SPECIAL_MODE>(value);
      auto preset_string = SpecialModeToPreset(this->special_mode_.value());
      ESP_LOGI(TAG, "Received special mode: %s", preset_string);
      // Only update preset if it's supported
      if (std::find(supported_presets_.begin(), supported_presets_.end(), preset_string) != supported_presets_.end()) {
        auto climate_preset = SpecialModeToClimatePreset(this->special_mode_.value());
        if (climate_preset.has_value()) {
          // Use standard preset
          this->set_preset_(climate_preset.value());
        } else {
          // Use custom preset
          this->set_custom_preset_(preset_string);
          this->set_preset_(climate::CLIMATE_PRESET_NONE);
        }
      }
      break;
    }
    case ToshibaCommandType::ODU_STATUS: {
      if (length != 22 && length != 24)  // Nerdhome: only the extended frames carry the data
        break;
      // Outdoor unit status - data offset depends on message length
      uint8_t odu_offset = (length == 22) ? 13 : 15;
      ESP_LOGI(TAG, "Received ODU status");
      {
        // Nerdhome: remember whether the compressor runs, for the climate action.
        uint8_t load_raw = rawData[odu_offset + 3];
        if (load_raw < 254) {
          this->compressor_running_ = load_raw > 0;
          this->last_odu_status_ms_ = millis();
        }
      }
      if (cdu_td_temp_sensor_ != nullptr) {
        int8_t val = static_cast<int8_t>(rawData[odu_offset + 0]);
        if (val != 127) {
          cdu_td_temp_sensor_->publish_state(val);
        }
      }
      if (cdu_ts_temp_sensor_ != nullptr) {
        int8_t val = static_cast<int8_t>(rawData[odu_offset + 1]);
        if (val != 127) {
          cdu_ts_temp_sensor_->publish_state(val);
        }
      }
      if (cdu_te_temp_sensor_ != nullptr) {
        int8_t val = static_cast<int8_t>(rawData[odu_offset + 2]);
        if (val != 127) {
          cdu_te_temp_sensor_->publish_state(val);
        }
      }
      if (cdu_load_sensor_ != nullptr) {
        uint8_t raw_val = rawData[odu_offset + 3];
        if (raw_val < 254) {
          cdu_load_sensor_->publish_state(raw_val / 1.7f);
        }
      }
      if (cdu_iac_sensor_ != nullptr) {
        uint8_t raw_val = rawData[odu_offset + 6];
        if (raw_val < 254) {
          cdu_iac_sensor_->publish_state(raw_val);
        }
      }
      break;
    }
    case ToshibaCommandType::IDU_STATUS: {
      if (length != 22 && length != 24)  // Nerdhome: only the extended frames carry the data
        break;
      // Indoor unit status - data offset depends on message length
      uint8_t idu_offset = (length == 22) ? 13 : 15;
      ESP_LOGI(TAG, "Received IDU status");
      if (fcu_tc_temp_sensor_ != nullptr) {
        int8_t val = static_cast<int8_t>(rawData[idu_offset + 0]);
        if (val != 127) {
          fcu_tc_temp_sensor_->publish_state(val);
        }
      }
      if (fcu_tcj_temp_sensor_ != nullptr) {
        int8_t val = static_cast<int8_t>(rawData[idu_offset + 1]);
        if (val != 127) {
          fcu_tcj_temp_sensor_->publish_state(val);
        }
      }
      if (fcu_fan_rpm_sensor_ != nullptr) {
        fcu_fan_rpm_sensor_->publish_state(rawData[idu_offset + 2]);
      }
      break;
    }
    default:
      ESP_LOGW(TAG, "Unknown sensor: %d with value %d", sensor, value);
      break;
  }
  this->rx_message_.clear();  // message processed, clear buffer
  this->update_action_();     // Nerdhome: cooling/heating/idle from mode + compressor
  this->publish_state();      // publish current values to MQTT
}

void ToshibaClimateUart::dump_config() {
  ESP_LOGCONFIG(TAG, "ToshibaClimate:");
  LOG_CLIMATE("", "Thermostat", this);
  if (outdoor_temp_sensor_ != nullptr) {
    LOG_SENSOR("", "Outdoor Temp", this->outdoor_temp_sensor_);
  }
  if (cdu_td_temp_sensor_ != nullptr) {
    LOG_SENSOR("", "CDU Td Temp", this->cdu_td_temp_sensor_);
  }
  if (cdu_ts_temp_sensor_ != nullptr) {
    LOG_SENSOR("", "CDU Ts Temp", this->cdu_ts_temp_sensor_);
  }
  if (cdu_te_temp_sensor_ != nullptr) {
    LOG_SENSOR("", "CDU Te Temp", this->cdu_te_temp_sensor_);
  }
  if (cdu_load_sensor_ != nullptr) {
    LOG_SENSOR("", "CDU Load", this->cdu_load_sensor_);
  }
  if (cdu_iac_sensor_ != nullptr) {
    LOG_SENSOR("", "CDU IAC", this->cdu_iac_sensor_);
  }
  if (fcu_tc_temp_sensor_ != nullptr) {
    LOG_SENSOR("", "FCU Tc Temp", this->fcu_tc_temp_sensor_);
  }
  if (fcu_tcj_temp_sensor_ != nullptr) {
    LOG_SENSOR("", "FCU Tcj Temp", this->fcu_tcj_temp_sensor_);
  }
  if (fcu_fan_rpm_sensor_ != nullptr) {
    LOG_SENSOR("", "FCU Fan RPM", this->fcu_fan_rpm_sensor_);
  }
  if (energy_sensor_ != nullptr) {
    LOG_SENSOR("", "Energy", this->energy_sensor_);
  }
  if (power_sensor_ != nullptr) {
    LOG_SENSOR("", "Power", this->power_sensor_);
  }
  if (pwr_select_ != nullptr) {
    LOG_SELECT("", "Power selector", this->pwr_select_);
  }
  if (vertical_air_direction_select_ != nullptr) {
    LOG_SELECT("", "Vertical air direction", this->vertical_air_direction_select_);
  }
  if (self_clean_sensor_ != nullptr) {
    LOG_BINARY_SENSOR("", "Self Clean", this->self_clean_sensor_);
  }
  if (!supported_presets_.empty()) {
    ESP_LOGCONFIG(TAG, "Supported presets:");
    for (const char* &preset : supported_presets_) {
      ESP_LOGCONFIG(TAG, "  - %s", preset);
    }
  }
  ESP_LOGI(TAG, "Min Temp: %d", this->min_temp_);
}

/**
 * Periodically request room and outdoor temperature.
 * It servers two purposes - updates data and is like "watchdog" because
 * some people reported that without communication, the unit might stop responding.
 */
void ToshibaClimateUart::update() {
  this->requestData(ToshibaCommandType::ROOM_TEMP);
  if (outdoor_temp_sensor_ != nullptr) {
    this->requestData(ToshibaCommandType::OUTDOOR_TEMP);
  }
  if (this->self_clean_running_) {
    this->requestData(ToshibaCommandType::SELF_CLEAN);
  }
  // Nerdhome addition: keep the plasma state in sync (e.g. when changed with the IR remote).
  if (this->plasma_switch_ != nullptr) {
    this->requestData(ToshibaCommandType::PLASMA);
  }

  uint32_t now = millis();

#ifdef USE_TIME
  // Handle time synchronization
  if (this->time_ != nullptr) {
    this->check_time_sync_(now);
  }
#endif

  // Periodic Energy Sync (Runs every 60s if energy or power sensors are configured)
  if ((this->energy_sensor_ != nullptr || this->power_sensor_ != nullptr) && (now - this->last_energy_sync_ > 60000)) {
    this->sync_energy_();
  }

  // Nerdhome: a compressor reading expires after ODU_STATUS_TIMEOUT_MS, so re-evaluate
  // the action here too (the unit may have stopped sending ODU status).
  auto previous_action = this->action;
  this->update_action_();
  if (this->action != previous_action) {
    this->publish_state();
  }
}

void ToshibaClimateUart::control(const climate::ClimateCall &call) {
  if (call.get_mode().has_value()) {
    ClimateMode mode = *call.get_mode();
    ESP_LOGD(TAG, "Setting mode to %s", climate_mode_to_string(mode));
    if (mode != CLIMATE_MODE_OFF) {
      this->set_self_clean_running_(false);
    }
    if (this->mode == CLIMATE_MODE_OFF && mode != CLIMATE_MODE_OFF) {
      ESP_LOGD(TAG, "Setting AC unit power state to ON.");
      this->sendCmd(ToshibaCommandType::POWER_STATE, static_cast<uint8_t>(STATE::ON));
    }
    if (mode == CLIMATE_MODE_OFF) {
      ESP_LOGD(TAG, "Setting AC unit power state to OFF.");
      this->sendCmd(ToshibaCommandType::POWER_STATE, static_cast<uint8_t>(STATE::OFF));
    } else {
      auto requestedMode = ClimateModeToInt(mode);
      this->sendCmd(ToshibaCommandType::MODE, static_cast<uint8_t>(requestedMode));
    }
    this->mode = mode;
  }

  if (call.get_target_temperature().has_value()) {
    auto target_temp = *call.get_target_temperature();
    uint8_t newTargetTemp = (uint8_t) target_temp;
    bool special_mode_changed = false;
    if (newTargetTemp >= MIN_TEMP_STANDARD && this->special_mode_ == SPECIAL_MODE::EIGHT_DEG) {
      // if target temp is above MIN_TEMP_STANDARD and special mode is EIGHT_DEG, change to Standard mode
      this->special_mode_ = SPECIAL_MODE::STANDARD;
      special_mode_changed = true;
      ESP_LOGD(TAG, "Changing to Standard Mode");
    } else if (newTargetTemp < MIN_TEMP_STANDARD && this->special_mode_ != SPECIAL_MODE::EIGHT_DEG) {
      // if target temp is below MIN_TEMP_STANDARD and special mode is not EIGHT_DEG, change to FrostGuard mode
      this->special_mode_ = SPECIAL_MODE::EIGHT_DEG;
      special_mode_changed = true;
      ESP_LOGD(TAG, "Changing to FrostGuard Mode");
    }
    if (special_mode_changed) {
      // send command to change special mode
      this->sendCmd(ToshibaCommandType::SPECIAL_MODE, static_cast<uint8_t>(this->special_mode_.value()));
    }

    ESP_LOGD(TAG, "Setting target temp to %d", newTargetTemp);
    if (this->special_mode_ == SPECIAL_MODE::EIGHT_DEG) {
      newTargetTemp += SPECIAL_TEMP_OFFSET;
      ESP_LOGD(TAG, "Note: Special Mode \"%s\" active, shifting setpoint temp to %d", SPECIAL_MODE_EIGHT_DEG,
               newTargetTemp);
    }
    // set the target temperature from HA to Climate component
    this->target_temperature = target_temp;
    // send command to set the target temperature to the unit
    // (which will be shifted by SPECIAL_TEMP_OFFSET if special mode is active)
    this->sendCmd(ToshibaCommandType::TARGET_TEMP, newTargetTemp);
  }

  if (call.get_fan_mode().has_value()) {
    auto fan_mode = *call.get_fan_mode();
    ESP_LOGD(TAG, "Setting fan mode to %s", climate_fan_mode_to_string(fan_mode));
    this->set_fan_mode_(fan_mode);
    auto fan_value = ClimateFanModeToInt(fan_mode);
    if (fan_value.has_value()) {
      this->sendCmd(ToshibaCommandType::FAN, static_cast<uint8_t>(fan_value.value()));
    }
  }

  if (call.has_custom_fan_mode()) {
    auto fan_mode = call.get_custom_fan_mode();
    auto payload = StringToFanLevel(fan_mode.c_str());
    if (payload.has_value()) {
      ESP_LOGD(TAG, "Setting fan mode to custom: %s", fan_mode.c_str());
      this->set_custom_fan_mode_(fan_mode);
      this->sendCmd(ToshibaCommandType::FAN, static_cast<uint8_t>(payload.value()));
    }
  }

  if (call.get_swing_mode().has_value()) {
    auto swing_mode = *call.get_swing_mode();
    auto function_value = ClimateSwingModeToInt(swing_mode);
    ESP_LOGD(TAG, "Setting swing mode to %s", climate_swing_mode_to_string(swing_mode));
    this->swing_mode = swing_mode;
    this->sendCmd(ToshibaCommandType::SWING, static_cast<uint8_t>(function_value));
    this->publish_vertical_air_direction_(function_value);
  }

  if (call.get_preset().has_value()) {
    auto preset = *call.get_preset();
    auto preset_string = ClimatePresetToString(preset);
    ESP_LOGD(TAG, "Setting preset to %s", preset_string);
    auto special_mode = PresetToSpecialMode(preset_string);
    if (special_mode.has_value()) {
      this->sendCmd(ToshibaCommandType::SPECIAL_MODE, static_cast<uint8_t>(special_mode.value()));
      // Set standard preset
      this->set_preset_(preset);

      // Handle special temperature logic for "8 degrees" mode
      if (special_mode.value() != this->special_mode_) {
        if (this->special_mode_ == SPECIAL_MODE::EIGHT_DEG && this->target_temperature < this->min_temp_) {
          // when switching from FrostGuard to Standard mode, set target temperature to default for Standard mode
          this->target_temperature = NORMAL_MODE_DEF_TEMP;
        }
        this->special_mode_ = special_mode.value();
        if (special_mode.value() == SPECIAL_MODE::EIGHT_DEG && this->target_temperature >= this->min_temp_) {
          // when switching from Standard to FrostGuard mode, set target temperature to default for FrostGuard mode
          this->target_temperature = SPECIAL_MODE_EIGHT_DEG_DEF_TEMP;
        }
      } else {
        this->special_mode_ = special_mode.value();
      }
    } else {
      ESP_LOGW(TAG, "Unknown preset: %s", preset_string);
    }
  }

  if (call.has_custom_preset()) {
    auto custom_preset = call.get_custom_preset();
    ESP_LOGD(TAG, "Setting custom preset to %s", custom_preset.c_str());
    auto special_mode = PresetToSpecialMode(custom_preset.c_str());
    if (special_mode.has_value()) {
      this->sendCmd(ToshibaCommandType::SPECIAL_MODE, static_cast<uint8_t>(special_mode.value()));
      // Set custom preset
      this->set_custom_preset_(custom_preset);

      // Handle special temperature logic for "8 degrees" mode
      if (special_mode.value() != this->special_mode_) {
        if (this->special_mode_ == SPECIAL_MODE::EIGHT_DEG && this->target_temperature < this->min_temp_) {
          // when switching from FrostGuard to Standard mode, set target temperature to default for Standard mode
          this->target_temperature = NORMAL_MODE_DEF_TEMP;
        }
        this->special_mode_ = special_mode.value();
        if (special_mode.value() == SPECIAL_MODE::EIGHT_DEG && this->target_temperature >= this->min_temp_) {
          // when switching from Standard to FrostGuard mode, set target temperature to default for FrostGuard mode
          this->target_temperature = SPECIAL_MODE_EIGHT_DEG_DEF_TEMP;
        }
      } else {
        this->special_mode_ = special_mode.value();
      }
    } else {
      ESP_LOGW(TAG, "Unknown custom preset: %s", custom_preset.c_str());
    }
  }

  this->update_action_();
  this->publish_state();
}

ClimateTraits ToshibaClimateUart::traits() {
  auto traits = climate::ClimateTraits();

  if (this -> heat_mode_disabled_) {
    traits.set_supported_modes({
      climate::CLIMATE_MODE_OFF,
      climate::CLIMATE_MODE_HEAT_COOL,
      climate::CLIMATE_MODE_COOL,
      climate::CLIMATE_MODE_DRY,
      climate::CLIMATE_MODE_FAN_ONLY
    });
  } else {
    traits.set_supported_modes({
      climate::CLIMATE_MODE_OFF,
      climate::CLIMATE_MODE_HEAT_COOL,
      climate::CLIMATE_MODE_COOL,
      climate::CLIMATE_MODE_HEAT,
      climate::CLIMATE_MODE_DRY,
      climate::CLIMATE_MODE_FAN_ONLY
    });
  }

  if (this -> horizontal_swing_) {
    traits.set_supported_swing_modes({
      climate::CLIMATE_SWING_OFF,
      climate::CLIMATE_SWING_VERTICAL,
      climate::CLIMATE_SWING_HORIZONTAL,
      climate::CLIMATE_SWING_BOTH
    });
  } else {
    traits.set_supported_swing_modes({climate::CLIMATE_SWING_OFF, climate::CLIMATE_SWING_VERTICAL});
  }
  traits.add_feature_flags(climate::CLIMATE_SUPPORTS_CURRENT_TEMPERATURE);
  // Nerdhome: report the action (cooling / heating / idle / fan / off).
  traits.add_feature_flags(climate::CLIMATE_SUPPORTS_ACTION);

  // Toshiba AC has more FAN levels that standard climate component, we have to use custom.
  traits.add_supported_fan_mode(CLIMATE_FAN_AUTO);
  traits.add_supported_fan_mode(CLIMATE_FAN_QUIET);
  traits.add_supported_fan_mode(CLIMATE_FAN_LOW);
  traits.add_supported_fan_mode(CLIMATE_FAN_MEDIUM);
  traits.add_supported_fan_mode(CLIMATE_FAN_HIGH);

  traits.set_visual_temperature_step(1);
  traits.set_visual_min_temperature(this->min_temp_);
  traits.set_visual_max_temperature(MAX_TEMP);

  // Add supported standard presets based on configuration (custom presets are set in setup())
  if (!this->supported_presets_.empty()) {
    for (const char *preset_string : this->supported_presets_) {
      auto climate_preset = StringToClimatePreset(preset_string);
      if (climate_preset.has_value()) {
        // preset is supported by the climate component
        traits.add_supported_preset(*climate_preset);
      }
    }
  }
  return traits;
}

void ToshibaClimateUart::on_set_pwr_level(const std::string &value) {
  ESP_LOGD(TAG, "Setting power level to %s", value.c_str());
  auto pwr_level = StringToPwrLevel(value);
  this->sendCmd(ToshibaCommandType::POWER_SEL, static_cast<uint8_t>(pwr_level.value()));
  pwr_select_->publish_state(value);
}

void ToshibaPwrModeSelect::control(const std::string &value) { parent_->on_set_pwr_level(value); }

void ToshibaClimateUart::on_set_vertical_air_direction(const std::string &value) {
  auto position = StringToVerticalAirDirection(value);
  if (!position.has_value()) {
    ESP_LOGW(TAG, "Unknown vertical air direction: %s", value.c_str());
    return;
  }

  ESP_LOGD(TAG, "Setting vertical air direction to %s", value.c_str());
  this->sendCmd(ToshibaCommandType::SWING, static_cast<uint8_t>(position.value()));
  this->publish_vertical_air_direction_(position.value());
  if (position.value() == SWING::VERTICAL || position.value() == SWING::BOTH) {
    this->swing_mode = climate::CLIMATE_SWING_VERTICAL;
  } else {
    this->swing_mode = climate::CLIMATE_SWING_OFF;
  }
  this->publish_state();
}

void ToshibaClimateUart::publish_vertical_air_direction_(SWING swing_mode) {
  if (vertical_air_direction_select_ == nullptr) {
    return;
  }
  auto position = SwingToVerticalAirDirection(swing_mode);
  if (position != nullptr) {
    vertical_air_direction_select_->publish_state(position);
  }
}

void ToshibaVerticalAirDirectionSelect::control(const std::string &value) { parent_->on_set_vertical_air_direction(value); }

// Nerdhome addition: plasma / ion filter.
void ToshibaClimateUart::on_set_plasma(bool state) {
  ESP_LOGD(TAG, "Setting plasma filter %s", state ? "ON" : "OFF");
  auto value = state ? PLASMA_STATE::ON : PLASMA_STATE::OFF;
  this->sendCmd(ToshibaCommandType::PLASMA, static_cast<uint8_t>(value));
  // Read the register back instead of publishing optimistically: the switch only
  // changes in Home Assistant when the unit confirms it.
  this->requestData(ToshibaCommandType::PLASMA);
}

void ToshibaPlasmaSwitch::write_state(bool state) { parent_->on_set_plasma(state); }

/**
 * Nerdhome addition: unit identification message (114 bytes, type 0xE0), sent unsolicited
 * by the unit every ~4-5 minutes. Fixed-width, NUL-padded ASCII fields:
 *   indoor:  model @13 (21), serial @34 (13), date code @47 (9), software @56 (7)
 *   outdoor: model @63 (21), serial @84 (13), date code @97 (9), software @106 (7)
 * Example: RAS-B10P2KVSG-E / 62601125 / 24081600 / 022020 and
 *          RAS-2M14G3AVG-E / 62500694 / 23151100 / 63E816 (two indoor units on one
 *          outdoor unit report the same outdoor fields).
 */
void ToshibaClimateUart::parse_unit_info_(const std::vector<uint8_t> &data) {
  auto field = [&data](size_t offset, size_t len) -> std::string {
    std::string out;
    for (size_t i = offset; i < offset + len && i + 1 < data.size(); i++) {
      uint8_t c = data[i];
      if (c == 0)
        break;
      if (c >= 0x20 && c < 0x7F)
        out += static_cast<char>(c);
    }
    return out;
  };
  auto publish = [](text_sensor::TextSensor *sensor, const std::string &value) {
    if (sensor != nullptr && !value.empty())
      sensor->publish_state(value);
  };
  std::string idu_model = field(13, 21);
  std::string odu_model = field(63, 21);
  ESP_LOGI(TAG, "Unit identification: indoor %s, outdoor %s", idu_model.c_str(), odu_model.c_str());
  publish(this->idu_model_sensor_, idu_model);
  publish(this->idu_serial_sensor_, field(34, 13));
  publish(this->idu_software_sensor_, field(56, 7));
  publish(this->odu_model_sensor_, odu_model);
  publish(this->odu_serial_sensor_, field(84, 13));
  publish(this->odu_software_sensor_, field(106, 7));
}

// Nerdhome addition: Wi-Fi LED switch. No read-back register, so publish directly.
void ToshibaWifiLedSwitch::write_state(bool state) {
  parent_->set_wifi_led(state);
  this->publish_state(state);
}

/**
 * Nerdhome addition: derive the climate action.
 * - off, or fan while the post-shutdown self-clean cycle runs
 * - fan in fan-only mode
 * - otherwise, with a recent ODU status: idle when the compressor stands still,
 *   else cooling / heating / drying by mode
 * - without ODU status (units that don't send it): by mode, as before
 */
void ToshibaClimateUart::update_action_() {
  climate::ClimateAction action;
  bool odu_fresh =
      this->last_odu_status_ms_ != 0 && (millis() - this->last_odu_status_ms_) < ODU_STATUS_TIMEOUT_MS;

  if (this->self_clean_running_) {
    action = climate::CLIMATE_ACTION_FAN;
  } else if (this->mode == climate::CLIMATE_MODE_OFF) {
    action = climate::CLIMATE_ACTION_OFF;
  } else if (this->mode == climate::CLIMATE_MODE_FAN_ONLY) {
    action = climate::CLIMATE_ACTION_FAN;
  } else if (odu_fresh && !this->compressor_running_) {
    action = climate::CLIMATE_ACTION_IDLE;
  } else {
    switch (this->mode) {
      case climate::CLIMATE_MODE_COOL:
        action = climate::CLIMATE_ACTION_COOLING;
        break;
      case climate::CLIMATE_MODE_HEAT:
        action = climate::CLIMATE_ACTION_HEATING;
        break;
      case climate::CLIMATE_MODE_DRY:
        action = climate::CLIMATE_ACTION_DRYING;
        break;
      case climate::CLIMATE_MODE_HEAT_COOL:
        action = (!std::isnan(this->current_temperature) && !std::isnan(this->target_temperature) &&
                  this->current_temperature < this->target_temperature)
                     ? climate::CLIMATE_ACTION_HEATING
                     : climate::CLIMATE_ACTION_COOLING;
        break;
      default:
        action = climate::CLIMATE_ACTION_IDLE;
        break;
    }
  }
  this->action = action;
}

/**
 * Scan all statuses from 128 to 255 in order to find unknown features.
 */
void ToshibaClimateUart::scan() {
  ESP_LOGI(TAG, "Scan started.");
  for (uint8_t i = 128; i < 255; i++) {
    this->requestData(static_cast<ToshibaCommandType>(i));
  }
}

/**
 * Expose Wi-Fi LED control
 */
void ToshibaClimateUart::set_wifi_led(bool enabled) {
  if (enabled) {
    ESP_LOGI(TAG, "Turning ON Wi-Fi LED");
    this->sendCmd(ToshibaCommandType::WIFI_LED_1, 0x05);
    this->sendCmd(ToshibaCommandType::WIFI_LED_2, 0x00);
  } else {
    ESP_LOGI(TAG, "Turning OFF Wi-Fi LED");
    this->sendCmd(ToshibaCommandType::WIFI_LED_1, 0x00);
    this->sendCmd(ToshibaCommandType::WIFI_LED_2, 0x80);
  }
}

#ifdef USE_TIME
void ToshibaClimateUart::check_time_sync_(uint32_t now) {
  if (!this->time_synced_) {
    // Boot sync or retry every 5 minutes until synchronized
    if (this->last_time_sync_ == 0) {
      ESP_LOGI(TAG, "Triggering initial time synchronization...");
      this->sync_time_();
    } else if (now - this->last_time_sync_ > 300000) {
      ESP_LOGI(TAG, "Retrying time synchronization...");
      this->sync_time_();
    }
  } else if (this->time_sync_interval_ != 0) {
    // Periodic synchronization after initial success
    if (now - this->last_time_sync_ > this->time_sync_interval_) {
      ESP_LOGI(TAG, "Triggering periodic time synchronization...");
      this->sync_time_();
    }
  }
}

void ToshibaClimateUart::sync_time_() {
  if (this->time_ == nullptr) {
    ESP_LOGW(TAG, "Time sync requested but no time_id is configured in YAML!");
    return;
  }
  if (!this->time_->now().is_valid()) {
    ESP_LOGI(TAG, "Time sync requested but time source is not yet valid/synchronized.");
    return;
  }
  auto now = this->time_->now();

  ESP_LOGI(TAG, "Syncing time to AC unit: %04d-%02d-%02d %02d:%02d:%02d", now.year, now.month, now.day_of_month, now.hour,
           now.minute, now.second);

  std::vector<uint8_t> payload = {2, 0, 3, 16, 0, 0, 0xef, 1, 48, 1, 0, 0xea, 0x99};
  payload.push_back((now.year - 2000) + 100);
  payload.push_back(now.month - 1);
  payload.push_back(now.day_of_month);
  payload.push_back(now.hour);
  payload.push_back(now.minute);
  payload.push_back(now.second);
  payload.push_back(now.day_of_week - 1); // Sunday=0
  payload.push_back(0x00);
  payload.push_back(0x00);
  for (int i = 0; i < 224; i++) {
    payload.push_back(0xFF);
  }
  payload.push_back(checksum(payload, payload.size()));

  // Enqueue the time sync packet and a 5-second delay to prevent collisions
  this->enqueue_command_(ToshibaCommand{.cmd = ToshibaCommandType::SET_DATE_TIME, .payload = payload});
  this->enqueue_command_(ToshibaCommand{.cmd = ToshibaCommandType::DELAY, .delay = 5000});
  this->last_time_sync_ = millis();
}
#endif

void ToshibaClimateUart::sync_energy_() {
  ESP_LOGV(TAG, "Syncing energy data");
  this->requestData(ToshibaCommandType::ENERGY_DAILY);
  this->last_energy_sync_ = millis();
}

void ToshibaClimateUart::estimate_wattage_(uint32_t current_energy) {
  uint32_t now = millis();
  if (this->last_energy_update_ms_ == 0 || current_energy < this->last_total_daily_energy_) {
    this->last_total_daily_energy_ = current_energy;
    this->last_energy_update_ms_ = now;
    return;
  }

  uint32_t energy_diff = current_energy - this->last_total_daily_energy_;
  uint32_t time_diff = now - this->last_energy_update_ms_;

  if (time_diff > 0 && energy_diff > 0) {
    float wattage = (energy_diff * 3600000.0f) / time_diff;
    if (this->power_sensor_ != nullptr) {
      this->power_sensor_->publish_state(wattage);
    }
  } else if (energy_diff == 0) {
    if (this->power_sensor_ != nullptr) {
      this->power_sensor_->publish_state(0);
    }
  }

  this->last_total_daily_energy_ = current_energy;
  this->last_energy_update_ms_ = now;
}

}  // namespace toshiba_suzumi
}  // namespace esphome
