jasperbom/nerdhome-breeze/(commit log)

2026-10-19 Nerdhome Breeze voor Toshiba: local wifi adapter for Toshiba AC (CN22) - board, enclosure, ESPHome package and firmware channel
    Claude-Session: https://claude.ai/code/session_01Mf6nz4xw5DsXgdSCXTYW1j
    [ESP32-C6-MINI-1U.step, toshiba-c6.kicad_pcb, toshiba-c6.kicad_sch, toshiba-c6_base.step, toshiba-c6_base.stl, toshiba-c6_bom_jlcpcb.csv, toshiba-c6_lid.step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]
2026-10-19 Add Breeze voor Daikin (S21): daikin-c6 board, ESPHome package and firmware channel; split boards into toshiba/ and daikin/
    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
    [ESP32-C6-MINI-1U.step, daikin-c6.kicad_pcb, daikin-c6.kicad_sch, daikin-c6_bom_jlcpcb.csv, toshiba-c6.kicad_pcb, toshiba-c6.kicad_sch, toshiba-c6_base.step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]
2026-10-23 Breeze voor Toshiba: plasmafilter, lamellen, draaiuren en afgevlakte ruimtetemperatuur
    - toshiba_suzumi (GPL-3, commit a306be6) opgenomen onder esphome/components met een
    plasmafilter-schakelaar (register 0xC7, 0x18 aan / 0x10 uit). Units zonder plasmafilter
    melden nooit een stand; de schakelaar blijft dan op Onbekend.
    - Lamellen standaard aan: verticale stand (select) en horizontaal zwenken.
    - Kamertemperatuur elke minuut opvragen (was 120 s) en als Ruimtetemperatuur publiceren
    met een glijdend gemiddelde over 10 minuten.
    - Draaiuren totaal en sinds onderhoud, instelbaar onderhoudsinterval (250 h), melding
    Onderhoud nodig en knop Onderhoud uitgevoerd. Flash-schrijfinterval 10 minute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
2026-10-23 Breeze voor Toshiba: actie, energie, presets, zelfreiniging, wifi-lampje en diagnose
    - hvac_action uit de compressorbelasting in de ODU-status (koelen/inactief/ventilator)
    - Energie vandaag (kWh) en geschat vermogen, met klok uit Home Assistant
    - Presets (Eco, Hi POWER, Silent, Sleep, Comfort, Fireplace)
    - Zelfreiniging als binary sensor, wifi-lampje als schakelaar
    - ODU/IDU-diagnose standaard verborgen; chiptemperatuur, IP, SSID, versie
    - Grenscontroles op korte energie- en statusberichten
    Claude-Session: https://claude.ai/code/session_01EZayWp1uPWDJatpF8KVjVo
2026-10-23 Breeze voor Toshiba: typenummers, serienummers en software van binnen- en buitendeel
    De unit stuurt na de handshake een identificatiebericht (114 bytes, type 0xE0)
    met vaste ASCII-velden. Die verschijnen nu als diagnose-tekstsensoren.
    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
2026-10-23 Toshiba: identificatiebericht komt periodiek, niet alleen na opstarten (documentatie) [skip ci]
    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
    [toshiba_climate.cpp]
